danieltyukov/owltunes/docs/hardware/README.md

# Hardware documentation

| Document | What it covers |
|---|---|
| [rev-a.md](rev-a.md) | Rev A blocks, mechanical stack, calculations, power budget, decisions |
| [pinmap.md](pinmap.md) | ESP32-S3 pin map (source: `firmware/main/board_owltunes_reva.h`) |
| [ring-test.md](ring-test.md) | Ring test prints, measurements and the decision record |
| [assembly.md](assembly.md) | Building an owl from the ordered parts |
| [bringup.md](bringup.md) | First power-on and checks |
| [ordering.md](ordering.md) | JLCPCB and JLC3DP settings, parts not on the boards |
| [rev-a-review.md](rev-a-review.md) | Design review before ordering |

KiCad projects: `hardware/`. Enclosure sources: `enclosure/`. Licence: CERN-OHL-P-2.0.
