danieltyukov/owltunes/sim/golden/ad_break.png

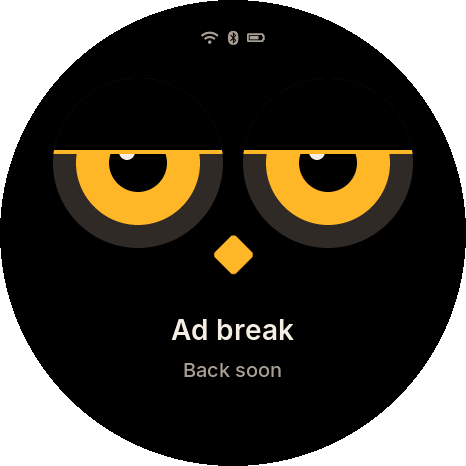
sim/golden/ad_break.png
