danieltyukov/owltunes/sim/golden/devices.png

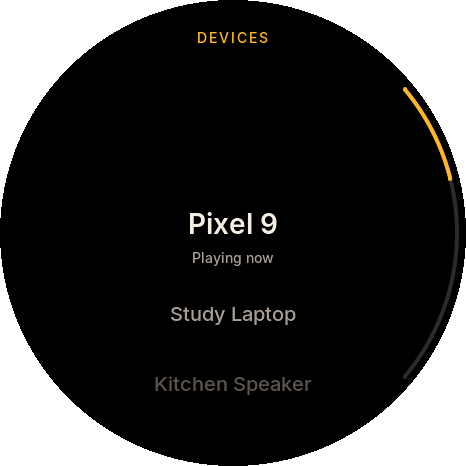
sim/golden/devices.png
