danieltyukov/owltunes/sim/golden/loading.png

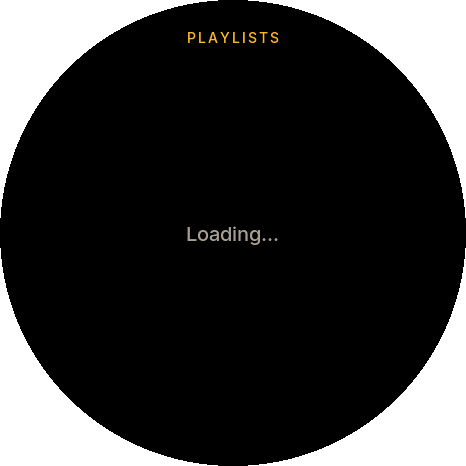
sim/golden/loading.png
