danieltyukov/owltunes/sim/golden/now_playing_unicode.png

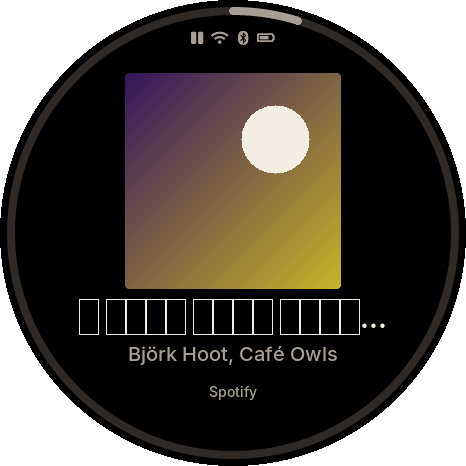
sim/golden/now_playing_unicode.png
