danieltyukov/owltunes/sim/golden/offline.png

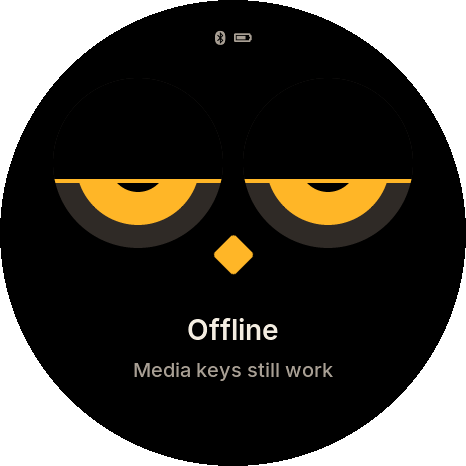
sim/golden/offline.png
