danieltyukov/owltunes/sim/golden/presets_screen.png

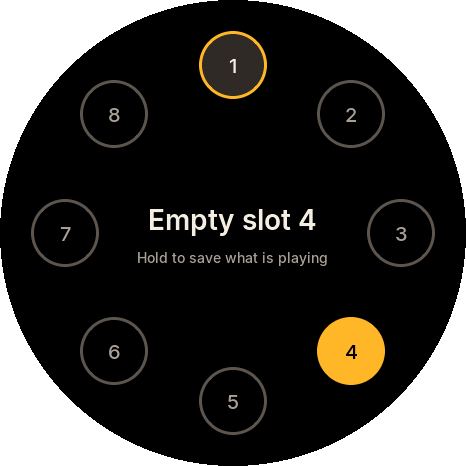
sim/golden/presets_screen.png
