danieltyukov/owltunes/docs/hardware/assembly.md

# Assembling an owl (rev A)

Tools: a soldering iron (for the inserts at 220 C, with a heat-set insert tip or a clean conical
tip, and for the LRA leads), solder and 1.5 mm heat-shrink tubing, a multimeter, a 1.3 mm hex key
for the ISO 7380 M2 button heads, cyanoacrylate glue, black 0.2 mm double-sided tape (the glass,
step 9), 1 mm double-sided foam tape (battery end stop, step 8), two-part epoxy (the bearing on its
seat, step 3) and a flat plate (glass or a steel rule) covered with release film (PTFE film or
packing tape) to set the bearing on. No crimp tool: the LRA gets a pre-crimped pigtail. Keep
cyanoacrylate away from the cover glass: its vapour leaves a white film. Also a piece of soft
silicone thermal gap pad, about 5 x 5 mm and 1.5 mm thick, 1 to 3 W/mK, electrically insulating
(see step 8).

The ring variant (A with the 6710 bearing, B with the printed bushing) and the magnet count come
from the ring test; see [ring-test.md](ring-test.md).

1. **Inserts.** Press M2 x 3 mm heat-set inserts into the four body bosses (behind the head
   corners and the belly) and the four back-cover standoffs.
2. **Magnets.** Ring carrier: alternate the polarity (see `ring-test.md`), a drop of glue each.
   The product carrier has no polarity bumps, so check each magnet against its neighbour with a
   reference magnet before the glue sets. Back cover: two D6 x 2 mm magnets in the cups at
   (+-20, -22), north facing out; the perch magnets face south out so they attract.
3. **Ring.** Cover the flat plate with release film and lay the bezel face down on it. Spread
   two-part epoxy thinly on the bearing seat, keeping it off the shields, and slide the bearing (or
   the bushing sleeve) onto the bezel tube from the back until it touches the plate: its front face
   is then flush with the bezel's front face, which is the glass ledge. The bearing pushes some
   epoxy forward: before it sets, lift the bezel off the film and wipe the bezel's front face and
   the inner race's front face clean, because they carry the glass tape, then lay it back face down.
   There is no lip in front of the bearing, so the epoxy holds it in both directions; let it set
   before going on. Press the ring on from the front until its lip rests on the outer race, and
   push the carrier into the ring from the back until its flange meets the ring.
4. **Keys.** Beak key into the face slot from inside; ear keys into the top slots from inside.
5. **LRA.** The motor's two leads (red and blue, about 27 mm, AWG 32) are spliced to a pre-crimped
   JST SH 1.0 mm 2-pin pigtail whose housing plugs into J302. Trim the pigtail to about 20 mm from
   its housing, slide a 10 mm piece of 1.5 mm heat-shrink tubing over each of its wires, strip
   about 3 mm of each wire and each motor lead, twist and solder red to the wire in housing pin 1
   and blue to pin 2, then shrink the tubing over the joints. The LRA has no polarity; the order
   only keeps every owl the same. Glue the motor into the back cover cup with its lead tab in the
   slot of the cup wall; the splices lie between the cup and J302.
6. **Battery.** The pack is a 2-wire 1S LiPo of the 803030 class (8 x 30 x 30 mm) with a protection
   circuit and a JST PH 2.0 2-pin plug: efaso 803030 740 mAh, or EEMB 803030 700 mAh if its plug is
   confirmed as PH 2.0 (2.0 mm pitch, not PH 1.25 or SH 1.0). The cavity is drawn for an 803040
   (8 x 30 x 40 mm), so the shorter cell is held by a foam end stop (step 8). The pack needs no NTC
   wire: the charger reads RT101, an NTC on the board under the cell. A 3-wire pack (with its own
   NTC) works too: move its positive and negative contacts into a 2-pin JST PHR-2 housing and
   insulate the NTC wire, which is unused. J101 has no reverse-polarity protection, and many packs
   are wired the other way round. Before plugging in, hold the plug the way it mates with J101 and
   check with a multimeter that the contact facing the `+` mark (pin 1, with the dot) is positive
   and the one facing `-` is negative; the red wire should be on `+`. If the order differs, lift
   each contact's latch with a needle and swap the two wires. No soldering. Do this for every pack,
   the spare too: J101 pin 1 is VBAT and pin 2 is GND.
7. **Dock pads.** Snap the dock-pad section off the perch board at the mouse bites, with pliers on
   the tab at the bite row, and file the nub flat: the owl recess and the perch pocket have a 0.8
   mm relief at the neck, but a nub over 0.4 mm reaches the battery margin. The section goes in one
   way only: J2 towards J303. Lay the back cover inner face up with its top edge away from you and
   glue the section into the recess with the gold pads facing out (down), J2 at the right (the LRA
   cup's end, the owl's right) and the notch at its other end over the tongue at the recess's left
   end. The silkscreen reads `J2 towards J303 >`, and the VBUS pad is the one nearest J2. If the
   section does not lie flat in the recess it is the wrong way round: turned, the VBUS pad would
   meet the perch's DET pin and put 5 V on GPIO1. Plug a straight 4-pin JST SH cable (pin 1 to pin
   1) into its J2; the other end goes to J303 on the main board in step 8. Before the first dock,
   with the cable in J2 and J303 and the cover not yet closed, check with a meter through the
   cover's pad windows: J303 pin 2 to the pad nearest J2 and J303 pin 3 to the pad farthest from J2
   show continuity (near 0 ohm). J303 pin 1 is at the end with the short silkscreen tick, on the
   left seen from the back (the owl's right). Any other result means a turned section or a reversed
   cable: fix it before the owl goes on a perch.
8. **Stack.** Put the main board into the body from the back, then the bezel and ring into the face
   opening so the bezel lugs rest on the board. Press the thermal gap pad onto the back of the
   board, centred on RT101's copper patch (the 4.5 x 3 mm rectangle under the mask, 4.5 mm below
   the centre of U303, with RT101 just past its right-hand end seen from the back; see
   [rev-a.md](rev-a.md), Off-board parts), so the cell rests on it. The battery space runs between
   the four cover standoffs, from the top edge of the dock-pad recess in the cover up to just below
   J101's plug. Lay the cell in lead end up, with its leads leaving the half of its top edge on the
   owl's right (your left, seen from the back) for J101, and check that it covers the gap pad. It
   is about 8 to 10 mm shorter than the space: stick an end stop of 1 mm double-sided foam tape to
   the inside of the back cover, just above the dock-pad recess, about 25 mm wide and three to five
   layers high, cut deep enough that it holds the cell's top edge just below J101's plug. Keep tape
   and foam off the cell's two large faces: the battery layer is 9.2 mm deep and the board's
   back-side parts under the cell stand up to 1.1 mm, so an 8 mm cell has only 0.1 to 0.2 mm to
   spare. The gap pad presses the cell against the cover once it is closed. Fold the spare battery
   lead into the space on the owl's right of the cell (your left, seen from the back), between the
   two cover standoffs on that side and clear of the LRA cup. Put the battery, motor plug and dock
   cable in place (J101, J302, J303), do the meter check of step 7 and close the back cover. Screw
   four ISO 7380 M2 x 6 from the front through the bezel lugs and the board into the cover
   standoffs, and four ISO 7380 M2 x 14 from the back through the cover spacers and the board into
   the body bosses. The back screw heads sit just below the cover's back face.
9. **Display.** The cover glass is laminated to the panel. The bearing must have passed the check
   in ring-test.md (M5): its inner race land reaches past the 52.75 mm largest glass edge and no
   shield stands proud of the race face; if one does, use tape thicker than 0.2 mm by that much.
   First lay a ring of the black 0.2 mm tape on the bezel's front face and on the inner race's front face (or the bushing sleeve's) out
   to 52.0 mm, at least 0.8 mm from the gap at the shields and open over the flex notch at 12
   o'clock. Lay the panel face down on a cloth and plug the adapter FPC into the panel connector
   (contacts towards the panel, the positioning line at the connector face). Then put the
   adapter's free end into J301 through the bezel opening (contacts down, the connector is bottom
   contact; pin 1 marking at J301's `31` end, which is the south end; connector pin k = panel pin
   32 - k) and close the latch. Lower the display into the bezel from the front so the adapter
   forms its U-turn towards 9 o'clock over the H2 lug: the panel goes into its pocket and the glass
   border comes down on the tape. Press the glass down evenly all round. Nothing but the tape holds
   the glass: there is no retainer, and only the turning ring surrounds its edge, about 0.5 mm
   away.
