danieltyukov/owltunes/sim/golden/setup_linking.png

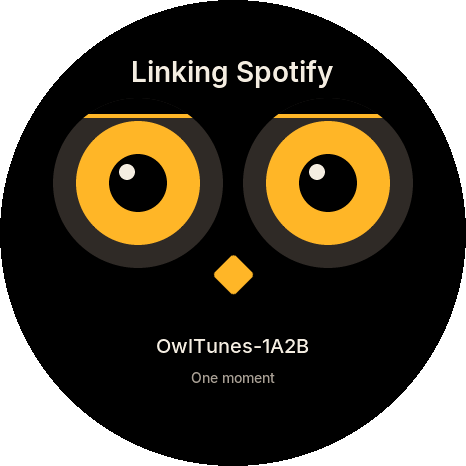
sim/golden/setup_linking.png
