danieltyukov/owltunes/hardware/perch-dock/perch-dock.kicad_pcb

## KiCad design hardware/perch-dock/perch-dock.kicad_pcb (2026-10-12)

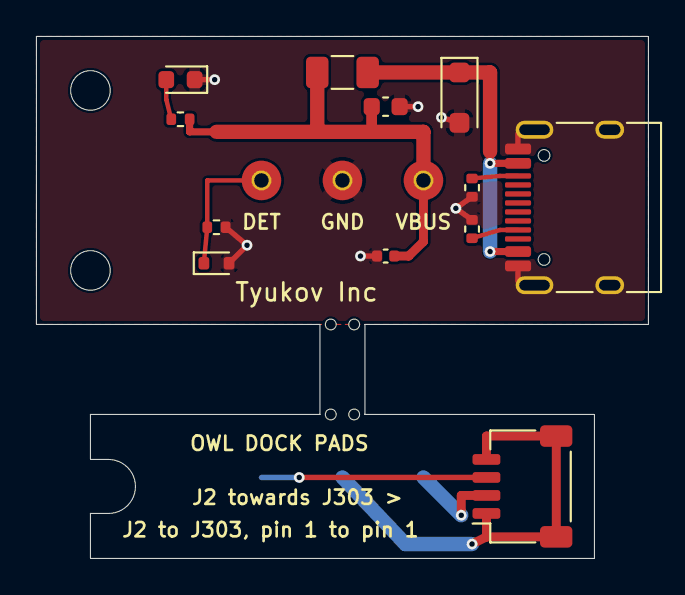
[picture p18: board perch-dock.kicad_pcb from above]

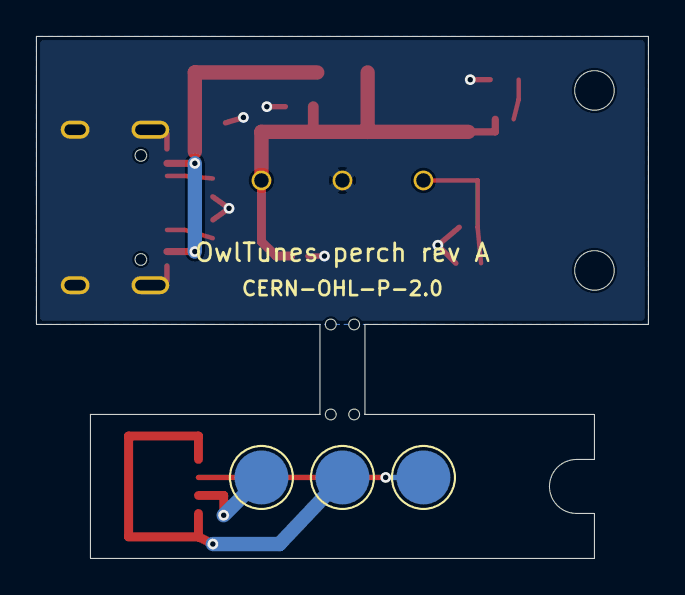
[picture p19: board perch-dock.kicad_pcb from below]

Board: 2 copper layers, 34.0 x 29.0 mm, 22 parts (3 on the bottom side), 10 nets.

Parts:
C1: 10uF; C_0603_1608Metric
C2: 100nF; C_0402_1005Metric
D1: SMF5.0A; D_SOD-123F
D2: LESD5D5.0CT1G; D_SOD-523
F1: 1.1A hold; Fuse_1206_3216Metric
H1, H2: M2; MountingHole_2.2mm_M2
J1: USB-C power; USB_C_Receptacle_HRO_TYPE-C-31-M-12
J2: To J303: GND, VBUS, DET, GND; JST_SH_SM04B-SRSS-TB_1x04-1MP_P1.00mm_Horizontal
LED1: red; LED_0603_1608Metric
MB1, MB2: Breakaway; MouseBite_2.5mm_2x0.6mm
P1: Pogo DET; PogoPin_Xinyangze_YZ71215080P-02
P2: Pogo GND; PogoPin_Xinyangze_YZ71215080P-02
P3: Pogo VBUS; PogoPin_Xinyangze_YZ71215080P-02
PAD1: DET; TestPoint_Pad_D3.0mm
PAD2: GND; TestPoint_Pad_D3.0mm
PAD3: VBUS; TestPoint_Pad_D3.0mm
R1, R2: 5.1k; R_0402_1005Metric
R3: 10k; R_0402_1005Metric
R4: 4.7k; R_0402_1005Metric

Connections:
DOCK_ID: D2.1, P1.1, R3.1
GND: C1.2, C2.2, D1.2, D2.2, J1.A1, J1.A12, J1.B1, J1.B12, J1.SH, LED1.1, P2.1, R1.2, R2.2, R3.2
LED_A: LED1.2, R4.2
PAD_DET: J2.3, PAD1.1
PAD_GND: J2.1, J2.4, J2.MP, PAD2.1
PAD_VBUS: J2.2, PAD3.1
PERCH_CC1: J1.A5, R1.1
PERCH_CC2: J1.B5, R2.1
VBUS_IN: D1.1, F1.1, J1.A4, J1.A9, J1.B4, J1.B9
VBUS_OUT: C1.1, C2.1, F1.2, P3.1, R4.1
