danieltyukov/owltunes/sim/src/sim_scenarios.c

#include "sim_scenarios.h"

#include <stdio.h>
#include <stdlib.h>
#include <string.h>

#include "sim_art.h"
#include "spotify_parse.h"

static char *read_fixture_file(const char *name, size_t *len)
{
    char path[512];
    snprintf(path, sizeof path, "%s/%s", OWL_FIXTURE_DIR, name);
    FILE *f = fopen(path, "rb");
    if (f == NULL) {
        fprintf(stderr, "missing fixture %s\n", path);
        exit(2);
    }
    fseek(f, 0, SEEK_END);
    long size = ftell(f);
    fseek(f, 0, SEEK_SET);
    char *buf = malloc((size_t)size + 1);
    *len = fread(buf, 1, (size_t)size, f);
    buf[*len] = '\0';
    fclose(f);
    return buf;
}

void sim_load_player(sim_world_t *w, const char *fixture)
{
    size_t len;
    char *json = read_fixture_file(fixture, &len);
    if (spotify_parse_player(json, len, w->now_ms, &w->player) != SPOTIFY_PARSE_OK) {
        fprintf(stderr, "cannot parse %s\n", fixture);
        exit(2);
    }
    free(json);
}

void sim_load_list(sim_world_t *w, owl_list_kind_t kind, const char *fixture, const char *source_uri)
{
    size_t len;
    char *json = read_fixture_file(fixture, &len);
    if (spotify_parse_list(kind, json, len, SIM_USER_ID, source_uri, &w->list) != SPOTIFY_PARSE_OK) {
        fprintf(stderr, "cannot parse %s\n", fixture);
        exit(2);
    }
    free(json);
}

void sim_input(sim_world_t *w, owl_input_kind_t kind, int32_t steps)
{
    owl_effects_t fx;
    owl_input_t in = {kind, steps};
    owl_app_handle(&w->app, &w->player, &in, w->now_ms, &fx);
}

static void base(sim_world_t *w)
{
    memset(w, 0, sizeof *w);
    owl_app_init(&w->app);
    owl_app_set_link(&w->app, OWL_LINK_API, true);
    owl_player_init(&w->player);
    w->inputs.battery_percent = 82;
    w->inputs.wifi = true;
    w->inputs.ble = true;
    w->now_ms = 100000;
}

static void no_device(sim_world_t *w)
{
    base(w);
    spotify_parse_player(NULL, 0, w->now_ms, &w->player);
}

static void now_playing(sim_world_t *w)
{
    base(w);
    sim_load_player(w, "player_track.json");
    w->player.liked = true;
    w->inputs.art = sim_art_for(w->player.track.uri);
}

static void now_playing_unicode(sim_world_t *w)
{
    base(w);
    sim_load_player(w, "player_unicode_paused.json");
    w->inputs.art = sim_art_for(w->player.track.uri);
}

static void now_playing_volume(sim_world_t *w)
{
    now_playing(w);
    w->player.device.volume_percent = 64;
    w->app.volume_overlay_until_ms = w->now_ms + 500;
}

static void offline(sim_world_t *w)
{
    base(w);
    owl_app_set_link(&w->app, OWL_LINK_NONE, true);
    w->inputs.wifi = false;
}

static void ad_break(sim_world_t *w)
{
    base(w);
    sim_load_player(w, "player_ad.json");
}

static void library(sim_world_t *w)
{
    now_playing(w);
    sim_input(w, OWL_IN_SWIPE_UP, 0);
}

static void playlists(sim_world_t *w)
{
    library(w);
    sim_input(w, OWL_IN_TAP, 0); /* cursor 0 = Playlists */
    sim_load_list(w, OWL_LIST_PLAYLISTS, "playlists.json", NULL);
    owl_app_set_list(&w->app, &w->list);
    sim_input(w, OWL_IN_RING, 1);
}

static void devices(sim_world_t *w)
{
    library(w);
    sim_input(w, OWL_IN_RING, OWL_LIB_DEVICES);
    sim_input(w, OWL_IN_TAP, 0);
    sim_load_list(w, OWL_LIST_DEVICES, "devices.json", NULL);
    owl_app_set_list(&w->app, &w->list);
}

static void loading(sim_world_t *w)
{
    library(w);
    sim_input(w, OWL_IN_TAP, 0); /* the playlists request has not answered yet */
}

static void playlist_items(sim_world_t *w)
{
    playlists(w); /* cursor 1 = Barn Party, a collaborative playlist that opens */
    sim_input(w, OWL_IN_TAP, 0);
    sim_load_list(w, OWL_LIST_PLAYLIST_ITEMS, "playlist_items.json",
                  "spotify:playlist:1wPw7n0lU8cLKk8qJx6lRZ");
    owl_app_set_list(&w->app, &w->list);
}

static void assign(sim_world_t *w, int slot, const char *uri, const char *label)
{
    w->app.presets[slot].assigned = true;
    snprintf(w->app.presets[slot].uri, sizeof w->app.presets[slot].uri, "%s", uri);
    snprintf(w->app.presets[slot].label, sizeof w->app.presets[slot].label, "%s", label);
}

static void presets_wheel(sim_world_t *w)
{
    now_playing(w);
    assign(w, 0, "spotify:playlist:3cEYpjA9oz9GiPac4AsH4n", "Night Flight Mix");
    assign(w, 1, "spotify:playlist:37i9dQZF1DXbITWG1ZJKYt", "Owl Jazz");
    assign(w, 4, "spotify:album:2up3OPMp9Tb4dAKM2erWXQ", "Moonlit Barn");
    sim_input(w, OWL_IN_EAR_LEFT_HOLD, 0);
    sim_input(w, OWL_IN_RING, 1);
}

static void presets_screen(sim_world_t *w)
{
    library(w);
    assign(w, 0, "spotify:playlist:3cEYpjA9oz9GiPac4AsH4n", "Night Flight Mix");
    sim_input(w, OWL_IN_RING, OWL_LIB_PRESETS);
    sim_input(w, OWL_IN_TAP, 0);
    sim_input(w, OWL_IN_RING, 3); /* an empty slot */
}

#define SIM_OWL_NAME "OwlTunes-1A2B"
#define SIM_SETUP_URL "https://danieltyukov.github.io/owltunes/setup/?owl=" SIM_OWL_NAME

static void setup_screen(sim_world_t *w, owl_ui_setup_mode_t mode, const char *error)
{
    base(w);
    w->inputs.ble = false;
    w->inputs.setup = (owl_ui_setup_t){mode, SIM_SETUP_URL, SIM_OWL_NAME, error};
}

static void setup_welcome(sim_world_t *w)
{
    setup_screen(w, OWL_UI_SETUP_WELCOME, NULL);
    w->inputs.wifi = false;
}

static void setup_link(sim_world_t *w)
{
    setup_screen(w, OWL_UI_SETUP_LINK, NULL);
}

static void setup_linking(sim_world_t *w)
{
    setup_screen(w, OWL_UI_SETUP_LINKING, NULL);
}

static void setup_link_failed(sim_world_t *w)
{
    setup_screen(w, OWL_UI_SETUP_LINK, "Spotify rejected the client ID");
}

static void setup_relink(sim_world_t *w)
{
    setup_screen(w, OWL_UI_SETUP_RELINK, NULL);
}

static const sim_scenario_t SCENARIOS[] = {
    {"no_device", no_device},
    {"now_playing", now_playing},
    {"now_playing_unicode", now_playing_unicode},
    {"now_playing_volume", now_playing_volume},
    {"offline", offline},
    {"ad_break", ad_break},
    {"library", library},
    {"playlists", playlists},
    {"devices", devices},
    {"loading", loading},
    {"presets_wheel", presets_wheel},
    {"presets_screen", presets_screen},
    {"playlist_items", playlist_items},
    {"setup_welcome", setup_welcome},
    {"setup_link", setup_link},
    {"setup_linking", setup_linking},
    {"setup_link_failed", setup_link_failed},
    {"setup_relink", setup_relink},
};

size_t sim_scenario_count(void)
{
    return sizeof SCENARIOS / sizeof SCENARIOS[0];
}

const sim_scenario_t *sim_scenario_at(size_t index)
{
    return index < sim_scenario_count() ? &SCENARIOS[index] : NULL;
}

const sim_scenario_t *sim_scenario_find(const char *name)
{
    for (size_t i = 0; i < sim_scenario_count(); i++) {
        if (strcmp(SCENARIOS[i].name, name) == 0) {
            return &SCENARIOS[i];
        }
    }
    return NULL;
}
