danieltyukov/owltunes/(commit log)

2026-10-04 docs: add OwlTunes system design spec
    Covers the owl handheld and desk perch, electronics, firmware architecture,
    Spotify Web API constraints, setup flow, UX, testing and delivery phases.
2026-10-04 feat(core): add button gesture recognition and ring step decoding
2026-10-04 feat(spotify): parse playlists, library, queue, devices and item lists
2026-10-04 feat(ui): add the centre-weighted list page for library, playlists and devices
2026-10-04 feat(ui): add the preset wheel and presets screen
2026-10-04 feat(firmware): add the ESP32-S3 firmware skeleton that boots the owl UI in QEMU
    Verified locally: the build has no warnings, and in QEMU the embedded player
    JSON parses and the UI loop logs OWL_BOOT_OK; a screenshot of the virtual panel
    shows the Now Playing page.
2026-10-04 fix(core): keep playlist and album names, and refuse to like local files
    Opening a playlist or album now records its name in the navigation frame, so
    playing from one of its tracks keeps the context name for presets and the list
    heading shows the name. Local files are no longer treated as likeable tracks.
    The spec now states the 216 px art size the UI uses.
    [sim_scenarios.c]
2026-10-10 docs: fix the pasted-line link flow and the monitor advice, and add setup caveats
2026-10-10 feat(enclosure): add ring test prints, sensor jig and field log analysis
2026-10-10 fix(enclosure): make the bezel glass fit in, fit the carrier to both rings, and use real SparkFun board data
    The glass now drops in from the front through a 48.5 mm opening. The carrier body is
    derived from the smaller ring bore with a named clearance. The jig places the TMAG5273 chip
    (from SparkFun's board file) on the sensor position, with a cable slot at connector J2, and
    its geometry is probed in tests. Nut pockets get clearance, the O-ring is 59 x 1.5 with a
    computed squeeze and stretch, and the magnet face depth matches a seated magnet. The log
    analysis uses percentiles, rejects glitches and non-finite samples, removes DC bias and
    tells a wrong turn length from a wrong polarity order.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
2026-10-10 fix(enclosure): bring every wall up to JLC3DP's MJF minimums
    Adds MJF_MIN_WALL (0.8, non-critical) and MJF_STRUCT_WALL (1.0, structural). Ring lip, FPC
    notch, carrier ID, front depth, flange and pocket depth change so every structural wall is at
    least 1.0 mm and the glass pocket wall is 0.8 mm. The wall test now measures chords along probe
    lines through each solid. Documents that the product carrier uses bumps=False.
2026-10-10 feat(hardware): add KiCad projects, JLC rules and the connectivity and ERC/DRC checks
2026-10-11 feat(firmware): pick the board with Kconfig, move QEMU into a board component and add the OTA flash layout
2026-10-11 feat(hardware): add the custom part library with datasheet pin checks
    hw_lib_build.py writes the five symbols from the datasheet pin tables and the
    footprints from the manufacturers' land patterns (TI DLA0010A and DNP0006A,
    Maxim 90-0065, Hirose FH26W, Murata DFE201612E, the pogo pin drawing), in
    the EasyEDA/JLC zero orientation, through kicad-cli so the files are what
    KiCad saves. EasyEDA data from JLC2KiCadLib is compared as a second source
    and supplies the untracked 3D models. The ESP32-S3-WROOM-1 copy opens the
    thermal vias to 0.3 mm.
    test_hw_library.py checks pin names and types, every pad, the printed
    drawing dimensions, stencil openings, courtyards, drills, the stock
    footprints the b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
2026-10-11 feat(firmware): add the Arduino Nano ESP32 board with octal PSRAM, a headless UI and the USB console
2026-10-11 docs: say which Nano ESP32 features arrive in later tasks and document console drops and a busy port
2026-10-11 feat(firmware): show the owl's status on the Nano ESP32's RGB LED
2026-10-11 fix(firmware): switch the status LED off before a restart, take one status snapshot per frame and count statuses
2026-10-11 fix(hardware): follow Hirose's stencil on J301 and keep pogo pin paste off its hole
    The FH26W contacts and tabs no longer print paste in full: paste-only
    openings follow the recommended stencil on EDC3-323714-05 p. 1 (0.23 wide,
    0.55 and 0.65 long flush with the pads' outer ends, tab openings 0.3 x 0.7).
    The pogo pin prints a ring of paste from 0.55 mm to the pad edge instead of
    a disc over its plated hole.
    The library test now compares every paste opening with the datasheet
    stencils, measures Hirose's printed stencil dimensions and checks the pogo
    ring against the hole; pins and lands count copper pads only. kicad-cli
    failures in the build script and the rebuild test print KiCad's output.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
2026-10-11 test(tools): flash, reset and check the Nano ESP32 from the host
2026-10-11 feat(enclosure): add enclosure v1 and the main board mechanical contract
    pcb_contract.py writes hardware/owl-mainboard/mech/contract.json: board
    outline, the 12 fixed parts with body boxes in the footprint frame, the
    EVQ-P7A knob box from the Panasonic drawing, mounting holes and keep-outs
    around every boss, the bezel lugs and the ring. U201 is placed at rot 180
    so the antenna points into the notch (checked with pcbnew); JST SH heights
    are 2.95.
    owl_v1.py builds the body, back cover, product bezel, a glass retainer
    ring, the beak and ear keys, the rings and the bump-free carriers. Every
    printed wall is at least 0.8 mm (1.0 where structural). The product Hall
    gap stays at 3.0 mm, provisional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
2026-10-11 feat(hardware): draw the main board power sheet (charger, gauge, 3.3 V, display switch)
2026-10-11 fix(enclosure): recess the back screw heads and record the glass retention
    The back cover counterbores were 1.0 mm deep, so the bought ISO 7380 M2
    button heads (k 1.3) stood 0.3 mm proud of the 23.5 mm envelope. They now
    run through the 1.5 mm plate (heads 0.2 mm below the back face), with a
    collar inside the plate around each boss to keep a 1.0 mm wall at the
    counterbore edge. owl_params names the screws (M2 x 6 front, M2 x 14
    back) and their head size; tests place a head and shank in every hole.
    The README lists the adhesive glass retention as an owner review point,
    with a mechanical lock for v2.
2026-10-11 feat(firmware): join the saved Wi-Fi networks in order with backoff and report failures to the setup page
    The Nano ESP32 gets Wi-Fi station mode (net_wifi.c, selected by CONFIG_OWL_NET_WIFI): one task
    carries out the owl_wifi plan, reports every failed attempt as a network failed event naming the
    SSID and the reason, and starts the radio even with nothing saved. Provisioning keeps only the
    newest network state and hands the saved networks over at boot. net_none.c is gone.
    On the board ESP-IDF v6.1 reports the owl's own leave during a scan or after a failed attempt as
    STA_LEAVING (36), which made the next saved network fail at once; the plan now ignores that reason
    unless the owl is online.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
2026-10-11 fix(hardware): limit the charger input to USB 2.0 default power and keep the USB attach capacitance under 10 uF
2026-10-11 fix(provisioning,tools): refuse an escaped NUL in wifi_add and tighten the Nano Wi-Fi checks
    wifi_add now refuses a request whose raw line holds the escape for U+0000, which cJSON
    decodes to a zero byte that cut the SSID or password short. In hil_nano.py the LAN check
    uses the page's ranges, the "up" marker is taken after the removals, the dummy password
    differs from the dummy SSID and the console log is checked for it, and the RAM floor is
    checked again after the join. wifi_checks gets a host test with a fake board.
2026-10-11 feat(hardware): draw the main board MCU, USB-C and button sheet
    The mcu_usb sheet carries the ESP32-S3-WROOM-1-N16R8 with 22 uF + 100 nF at
    its 3V3 pin, the EN network (10k, 1 uF, reset pad), the GPIO0 pull-up with
    the boot pads, the 32.768 kHz crystal with 18 pF load capacitors, USB-C with
    a separate 5.1k Rd per CC pin, USBLC6-2SC6, 22 ohm series resistors and the
    VBUS TVS, the three buttons with 100k pull-ups and 10 nF, the J202 expansion
    connector with 10k pull-ups, the UART pads, a notes box and the GPIO table.
    TPS63802 PG now reaches ESP_EN through R212 (1k) on its own net TPS_PG, so
    the open-drain PG output no longer discharges the 1 uF EN capacitor directly.
2026-10-11 feat(provisioning): refuse spotify_begin while the owl is offline
    esp_fill_random is truly random only while the radio runs. The real boards start Wi-Fi before the
    console, and the owl now also refuses to start a login until it is online, so the PKCE verifier
    is always made with the radio on, whatever the start-up order (bootloader_random_enable() must
    not run beside the radio). Offline, the login could not finish anyway and the state would carry
    no address for the LAN fallback. The reply is the new error offline; a login that is already
    open stays open. The setup page explains it, the fake owl in the page tests refuses the same
    way, and tools/hil_nano.py checks the refusal on a board with n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
2026-10-11 test(tools): link a board to Spotify through a loopback redirect and check the boot refresh
    tools/owl_login.py serves http://127.0.0.1:8765/callback, saves the client ID on the owl with
    that redirect URI, prints the login address and hands Spotify's code to the owl over USB; the owl
    exchanges it itself. It then resets the owl and waits for the saved login to pass its boot check.
    Opening the port restarts the Nano, so the script opens it once, waits for the owl to start and
    come online, and keeps it open. It listens before it saves the redirect URI, skips callbacks
    for another login, shows the client ID as <redacted> in the console log (Board.redact) and
    fails if the log holds a token name or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
2026-10-11 fix(hardware): keep TPS63802 PG under 1 mA on the ESP32 EN network and leave the USBLC6 VBUS pin open
    EN now uses R205 47k, C203 220 nF and R212 4.7k: PG sinks at most
    3.3 V / 4.7k = 0.70 mA, the divider holds EN at 0.30 V or less while PG is
    low, EN releases with a 10.3 ms time constant and PG glitches shorter than
    about 1 ms are filtered.
    U202 pin 5 is no longer tied to VBUS_USB, so the ESP32-S3's D+ pull-up
    cannot back-feed the receptacle VBUS through the upper steering diode while
    unplugged.
    The notes boxes on both sheets state these numbers, and the mcu_usb notes
    record that the U0TXD 499 ohm series resistor is inside the module.
2026-10-11 feat(spotify): ask whether the current track is in the person's library
2026-10-11 fix(tools,firmware): redact client IDs in every console log and throttle the callback stop log
    Board's log writer now shows every 32-hex client ID as <redacted> by pattern (the "client_id"
    field of hello and client_id= in an authorize URL), whatever the script and whether or not the
    ID was passed in; tools/qemu_prov_test.py uses the same redact_line. The loopback callback
    server in tools/owl_login.py runs each connection on its own thread with a 10 s timeout, so a
    stray connection cannot hold up Spotify's redirect. A failing httpd_stop is still retried on
    every pass but logged at once, then at most every 30 s with the attempt count, and once when it
    finally stops. The PKCE comments and the p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
2026-10-11 feat(hardware): draw the display, sensor and dock sheet; main board ERC clean
    The periph sheet carries J301 (FH26W-31S, connector pin k = panel pin
    32 - k as on the Waveshare 1.75 kit J3) with a pin table aligned to the
    connector pins, the panel decoupling and the touch bus pull-ups to
    DISP_3V3, the DRV2605L on +3V3 with the LRA connector, the TMAG5273A2,
    the LIS2DW12, the OPT3001, the sensor bus pull-ups, and the dock link
    (J303, SMF5.0A, DOCK_DET divider with ESD). hw_netlist now runs in CI
    for the main board.
    One change to the planned parts: LIS2DW12 SDO/SA0 reaches +3V3 through
    R309 10k (C25744, already on the board) on the new net IMU_SA0 instead
    of a hard tie. The pin is an I/O (SPI S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
2026-10-11 feat(firmware): add the rev A pin map header with a host test of the ESP32-S3 pin rules
2026-10-11 feat(tools): check the rev A pin map header against the main board netlist
2026-10-11 feat(hardware): bring the main board schematic into the PCB and apply the enclosure contract
    hw_sync.py is the scripted Update PCB from Schematic (footprints, fields, symbol paths,
    attributes, pad nets; placed parts keep their position). hw_contract.py applies the outline,
    fixed parts and holes from contract.json and checks them, the battery-zone heights, the
    Hall-sensor keep-out, the boss, lug and ring keep-outs and each fixed part's body against the
    box the enclosure reserves for it.
2026-10-11 docs(hardware): add the rev A notes, pin map, assembly and bring-up guides
2026-10-11 docs(hardware): state the worst-case charger input limit and where to read the TS voltage
2026-10-11 fix(firmware): give the typical and worst-case charger input limit in the rev A header
2026-10-11 fix(enclosure): turn J301 to 180 degrees so the display flex enters from the panel's top edge
    The FH26W takes the FPC from footprint +v. At rot 0 that side faced the display centre, so the
    flex that folds over the panel's top edge and runs down behind it would have needed a second
    fold. At rot 180 it runs straight in; the reach stays provisional until the paper check.
2026-10-11 feat(hardware): place the main board against the enclosure contract
    hw_place.py places the 86 free parts by function (decoupling at the pins they serve, charger in
    the right strip outside the battery, 3.3 V block at the cell edge with L101 clear of the cell,
    U104 outside the H2 boss ring, ESD and TVS at the connectors) and puts each reference where it
    clears all copper. J101 carries + NTC - and a pin 1 dot. fit_check.py checks the STEP export,
    plus the contract boxes for parts without a local 3D model, against enclosure v1. The contract
    check runs in CI. The stackup test compares tokens, since pcbnew re-indents the block.
2026-10-11 fix(shell): accept transfer ids of 1 to 63 characters, the length a command can hold
    owl_cmd_t keeps a device id in 64 bytes, so a 64-character id parsed but
    was refused later as no_such_device. The console now answers it with
    bad_arg at once (P16 as amended), and a 63-character id reaches the command
    whole.
2026-10-11 feat(hardware): keep parts out of the strips beside the antenna notch in the contract
    The contract now lists 3 mm strips either side of both notch edges above y 33, on both board
    sides, as keep-outs that name U201. hw_contract.py exempts the part a keep-out names, so the
    module itself does not trip its own strips; every other courtyard must stay out.
2026-10-11 feat(firmware): poll Spotify and send console commands through the runtime
    The runtime now talks to the Web API over the kept-alive connection. Each
    pass sends at most one request: the oldest queued command, then a device
    list or like check the console asked for, then the playback poll when the
    spec 9.4 scheduler says it is due. Every answer goes to the shared gate
    (api_gate_record_web); a 401 gets one forced token refresh and one more
    try, and a request that could not get a token records nothing. Commands
    are resolved against the last known state, applied optimistically and
    confirmed by the poll half a second later. While the gate is closed,
    playback commands and devices are refused with ba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
2026-10-11 docs: describe the console's playback commands, player, device and api lines
    docs/console.md now covers the commands the runtime sends to Spotify,
    the cmd states and every error code (backoff distinct from rate_limited,
    P18), the player and device lines and the screen-on polling window. The
    board guide says which statuses show once the owl reads the playback
    state.
2026-10-11 fix(hardware): raise R102 to 3.6k so the charger input limit stays under 500 mA at its worst case
2026-10-11 docs(hardware): an open TS reads as cold on this board, so the pack needs its 10k NTC
2026-10-11 docs(hardware): give the R102 3.6k input limits and rework the bring-up battery step
2026-10-11 docs(firmware): note that ext1 must only arm the rev A wake pins that read high
2026-10-11 fix(tools): fail the pin map check when the header has no pins or the netlist has no U201 GPIOs
2026-10-11 test(firmware): run the Spotify runtime's steps on the host
    test_spotify_task builds spotify_task.c and the shared gate against
    stand-ins for FreeRTOS, the token service and the transport. It pins the
    request order (one per pass, commands first, the confirming poll 500 ms
    later), the 401 path (one forced refresh, one more try, then auth), that a
    request without a token is neither sent nor recorded, refusals while the
    gate is closed with backoff distinct from rate_limited (P18), the quota
    lockout's BLE link, device numbers for transfer and what stopping does.
2026-10-11 fix(hardware): cut the WROOM-1 antenna keep-out to the owl notch and strips
    Ruling R43: the module copy's courtyard and rule area (no tracks, vias, pads, pour or parts on
    any copper layer) now cover only the board notch plus the 3 mm strips beside it, the same
    geometry as the contract keep-outs, instead of Espressif's 48 x 21 mm area that held the ear
    switches. Espressif's 15 mm keep-out cannot fit in the 66 x 84 mm owl; RSSI is measured at
    bring-up and the ring test decides WROOM-1 or WROOM-1U. hw_lib_build.py makes the cut, so a
    library rebuild keeps it. hw_sync.py now replaces footprints whose library copy changed, and
    hw_contract.py checks that U201's rule area covers the strip keep-outs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
2026-10-11 feat(hardware): draw the perch board and owl dock-pad schematics; perch ERC clean
2026-10-11 feat(hardware): lay out and route the perch board with the snap-off dock-pad section; perch DRC clean
2026-10-11 fix(firmware): hand a 401 on to the runtime and resend after a stale TLS connection
    ESP-IDF 6.1 fails every 401 inside esp_http_client_perform: it tries Basic
    or Digest auth, which are not built in, and returns ESP_ERR_NOT_SUPPORTED
    before the body is read. spotify_http_call now treats any failure after a
    status line as Spotify's answer with that status (P32), marks the body as
    cut and drops the connection, so the runtime's 401 refresh can happen.
    The host stand-in fails 401s the way IDF does.
    A stale kept-alive TLS connection comes back as ESP_ERR_HTTP_FETCH_HEADER,
    not CONNECTION_CLOSED, so that error is resent once too when the
    connection was reused and nothing was answered (P8 as amende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
2026-10-11 feat(enclosure): add perch v1 with the board pocket, screw bosses, owl seat and pogo pin stroke
2026-10-11 test(tools): drive the Spotify runtime on the Nano ESP32 against a real account, opt-in
2026-10-11 docs: describe the Nano ESP32 dev board, its Spotify console and the opt-in real-account test
2026-10-11 fix(tools): print hil_spotify's command outcome without a stray space
2026-10-11 fix(enclosure): trim the perch base flush with the rest back and join the J1 cavity to the pin window, no wall under 0.8 mm
2026-10-11 fix(hardware): straighten the USB pair, move C304 and C106 to their pins, put the holes on the front
    R203 and R204 stand below U201 pins 14 and 13 with their connector pads at the bottom, and U202
    turns to 180 so D+ runs above D- on both sides: the pair goes from J201 through U202 to U201
    without crossing (0 crossing airwires). C304 spans DRV2605L VDD pin 10 and GND pin 8, C106 sits
    at TPS63802 VIN pin 10 with C105 behind it, and L101's courtyard leaves the battery zone (R44).
    H1 to H8 are front in design.toml, as on the board (a bare hole has no side), and the side test
    covers them. mark_j101 removes only its own pin 1 dot. R102 3.6k synced from the schematic.
2026-10-11 fix(hardware): count 0.1 mm pad stand-off in the battery rule and test each contract rule
    Ruling R44: a part under the battery fails when its design.toml height plus 0.1 mm exceeds the
    1.2 mm limit. contract_errors() returns the error list, and the tests assert the exact lines for
    the battery rule on its own (1.1 mm passes, 1.15 mm fails) and for the Hall-sensor keep-out.
2026-10-11 fix(enclosure): check every part in the fit check, with boxes where a 3D model is missing
    Ruling R45: tools/hw/hw_export3d.py exports the STEP and lists each part kicad-cli has no model
    for (the EasyEDA models are gitignored) with its courtyard and design.toml height. fit_check.py
    extrudes those courtyards (height plus the 0.1 mm stand-off), uses the contract box for fixed
    parts, names both groups and refuses to run without the list.
2026-10-11 fix(tools): put the account back after a failed or interrupted hil_spotify run and check that prev returns to the first track
2026-10-11 feat(hardware): route the TPS63802 power loop
    tools/hw/hw_route.py draws the hand-routed groups as locked B.Cu tracks. The TPS63802 group: L1
    and L2 at 0.5 mm straight into L101 (necked to 0.3 mm at the 0.5 mm pitch pins, entering the
    inductor pads clear of its no-track area), VIN from pin 10 through C106 to C105 at 0.5 mm, EN to
    VIN below the package, VOUT from pin 6 through C107 to C108 at 0.5 mm, C109 and the top of the
    feedback divider from C107, FB from pin 4 to R107 and R108 on the side away from L1 and L2 (R107
    turned so its FB pad faces R108), GND pins 2, 3 and 8 joined between the pad rows. GND vias and
    the In1 tie come with the planes. DRC: no new violation type, 272 to 259 unconne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
2026-10-11 fix(firmware): fail the old account's waiting commands when a new login arrives
    Since commands can wait in the coalescing queue across passes, a login
    change could send them to the new account. The runtime now answers each
    of them with failed login_changed before it polls the new account, next
    to forgetting the token, the device numbers and the player. The console
    doc lists the new error and says that three vol +5 merge into one request
    only while another request is under way.
2026-10-11 feat(hardware): route the charger power paths and the fuel gauge Kelvin tap
    VIN_CHG from BQ24073 pin 13 to C101 and on to the D101 and D102 cathodes, VSYS from pins 10 and
    11 to C102 and TP102, VBAT from pins 2 and 3 to C103 and up past TP103, outside the H1 boss
    ring, to J101 pin 1: 0.5 mm, necked at the 0.5 mm pitch pins and 0.4 mm between C103 and R103.
    The MAX17048 CELL and VDD pins run on their own 0.25 mm trace to J101 pin 1 with C104 at pin 3
    (R37). U101's thermal vias wait for the In1 and In2 planes (on their own they are dangling).
    DRC: no new violation type, 259 to 246 unconnected.
2026-10-11 feat(hardware): route the USB pair from U202 to the ESP32-S3
    USB_DP_CONN and USB_DM_CONN run through U202 under its body, then as a 0.2 mm pair with 0.15 mm
    gap east, up a clear corridor at x 5.65/6.0 between the IMU and the TPS63802 divider, and into
    R203/R204 from below, D+ on the left of travel at every turn so the lines never cross; USB_DP and
    USB_DM are the short stubs to U201 pins 14 and 13. Lengths: D+ 62.6 + 2.5 mm, D- 64.2 + 4.9 mm
    (full speed, no matching needed). The J201 fan-out to U202 is left for the next session. DRC: no
    new violation type, 246 to 240 unconnected.
2026-10-11 test(firmware): pin that a connection the transport closed is fresh again
    The first request after spotify_http_close (a logout, the network going
    down) goes out on a new connection, so a FETCH_HEADER there is not sent
    twice (P8).
2026-10-11 feat(hardware): route the 32.768 kHz crystal
    U201 pins 8 and 9 run straight to Y201 (3.5 mm each, 0.15 mm), and on to the C204 and C205 load
    caps on the crystal's far side (1.9 mm). Nothing else runs between the crystal and the module;
    pins 7 and 10 have to escape another way when the rest is routed. hw_route.py also holds the
    dock group, routed in the next commit. DRC: no new violation type, 240 to 236 unconnected.
2026-10-11 feat(hardware): route the dock power and pad lines
    VBUS_DOCK runs from J303 pin 2 through the D301 TVS and up the right side, clear of the H4 boss
    ring and U301, to the D102 anode at 0.5 mm (29.6 mm). DOCK_PAD runs from J303 pin 3 through the
    D302 ESD diode to R307 (6.5 mm, 0.25 mm). DRC: no new violation type, 236 to 232 unconnected.
2026-10-11 feat(hardware): route the USB-C fan-out to the ESD array
    J201's D+ pads (A6, B6) drop to vias just above the pad row and its D- pads (A7, B7) to vias just
    below it; each pair joins on F.Cu over the solid In1 GND and comes back up beside U202 pins 6 and
    4 (0.2 mm, D+ 9.9 mm, D- 11.1 mm, three vias each). D- passes below the J201 peg hole and the
    through-hole shell tab. B.Cu above the pads stays free for CC1, CC2 and VBUS. The USB nets are now
    fully connected from J201 to U201. DRC: no new violation type, 232 to 228 unconnected.
2026-10-11 fix(hardware): put the perch mouse bites on the neck edges and move J1 1.5 mm down for a full-size USB-C plug
2026-10-11 fix(enclosure): fit the full-size USB-C overmold, relieve both pockets for the neck nub, and tie perch_v1 to the board
2026-10-11 fix(tools): tag each hand-route group so a re-run removes its old copper
    hw_route.py now puts a group's tracks and vias into a KiCad group named
    "hw_route <group>", and a re-run deletes everything in that group before
    drawing again, so edited coordinates leave no stale locked copper (review
    M3). Untagged copper at the group's exact coordinates is still replaced.
    Items are removed with Board.Delete: Board.Remove gives the C++ item to
    its Python wrapper, and once that wrapper is freed the board's track list
    stops being iterable in KiCad 10.0.6, which broke a re-run halfway.
    All seven part A groups were re-run to tag their 109 items; the copper is
    unchanged.
2026-10-11 feat(hardware): route the QSPI display bus and LCD_TE to J301
    LCD_CLK, LCD_CS and LCD_D0 to LCD_D3 run from the module's FSPI IO_MUX
    pins (B.Cu) to J301 (F.Cu) at 0.1 mm with one via each and no track
    between J301's pads. D2, CLK and D0 turn west, run down the back under
    J301 and come back east below it, which reverses their order for the
    bottom row; D1 drops to F.Cu at the module and CS crosses under it on
    B.Cu, as in the review's routing plan. A D1 serpentine and CS and D3
    trombones bring the lengths to 13.7 to 16.1 mm (LCD_CLK 16.1 mm). LCD_TE
    leaves the module's left column and reaches its pad on F.Cu.
    GND vias sit beside each layer change; two of them also feed J301 GND
    pins 10 and 20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
2026-10-11 fix(hardware): tie the TPS63802 input and output caps to the GND planes
    The VSYS and +3V3 runs fence the GND pads of C105 to C108 off from the
    TPS63802 GND pins on B.Cu, so the input and output loops have to close
    through vias into In2 GND, which stays GND under the part, and In1
    (review I1). Ten 0.3/0.5 mm GND vias: one beside each GND pad of C105 to
    C109, two in the channel between U103's pad rows, two west of pins 2 and
    3, and one at R108's end of the feedback divider. Each is joined to its
    pad by a short stub, so no via sits in a pad. DRC: no new violation
    type; the vias show as via_dangling (17 in all) until the planes exist.
2026-10-11 fix(firmware): send Web API requests that have no body
    ESP-IDF 6.1 answers ESP_ERR_NOT_FOUND when esp_http_client_set_post_field
    drops a Content-Type header that was never set, and the owl took that as a
    failed request. Every GET, and every command without a body, failed before
    it left the board, so the owl never read the playback state and backed off.
    The host fake now answers like ESP-IDF 6.1.
2026-10-11 fix(tools): wait for the owl to come online before the real-account test
    Opening the port restarts the Nano ESP32, so the first hello came before
    it had joined Wi-Fi and the test failed at its first check.
2026-10-11 fix(hardware): keep the charger's paste off its open thermal vias
    U101 (BQ24073 RGT) now uses a project copy of KiCad's ThermalVias
    footprint, owltunes:VQFN-16-1EP_3x3mm_P0.5mm_EP1.6x1.6mm_ThermalVias_Drill0.3,
    built by hw_lib_build.py: the four vias at the corners of the 1.6 mm
    exposed pad are opened from 0.2 to 0.3 mm and stay open (no plugging),
    and the stock paste windows, which sat over the vias, are redrawn round
    them (review I2). A 1.5 x 0.6 bar and two 0.6 x 0.35 arms keep 0.1 mm
    from each drill, touch no 0.5 mm via pad and print 51.6 % of the pad
    (TI's guidance for RGT is roughly 50 to 80 %). The via grid moves from
    0.8 to 1.1 mm pitch: at 0.8 mm no window layout clear of the vias g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
2026-10-11 feat(hardware): route the VIN_CHG taps to TP101 and R103
    TP101 hangs off the D101/D102 cathode run at 0.5 mm, passing above the
    diode anodes so D101's VBUS_USB anode can still be reached from the east
    and from below TP101. R103, the CHG_EN2 pull-up, sits between the VBAT
    and VSYS runs north of U101, so its tap crosses on F.Cu west of U101
    with a via at each end, clear of the area below U101 pin 1 that BAT_NTC
    will use. DRC: no new violation type, 222 unconnected.
2026-10-11 feat(hardware): route TPS_PG from the TPS63802 to R212
    U103 pin 5 drops to a via in the pocket west of the pin, inside the +3V3
    and feedback runs, then runs 36 mm on F.Cu, east of the crystal and its
    load caps so nothing sits on F.Cu under them, to a via beside R212 on the
    ESP32 EN network. DRC: no new violation type, 221 unconnected.
2026-10-11 feat(hardware): tie the part A caps, charger, gauge and ESD parts to GND
    GND for the hand-routed parts whose GND pads a pour cannot reach
    directly or that need a short path to the planes (Step 1 item 5). U101's
    GND pins 4 (boxed in by VBAT, review focus answer 2), 8 and 15 run
    0.2 mm into its exposed pad and thermal vias; U102's pins 4 and 6 into
    its pad, which gets a via on its west side, outside the paste. One via
    beside each GND pad of C101 to C104 and of the crystal load caps C204
    and C205. The USB ESD array's GND pin, boxed in by the USB lines, drops
    through a via under its body; the D301 TVS gets two vias and the D302
    ESD diode one. DRC: no new violation type, via_dangling 28 (all GND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
2026-10-11 fix(hardware): run VBAT at 0.5 mm past C103 and R103 and branch at vertices
    The VBAT run between C103 and R103 and the TP103 spur are now 0.5 mm
    (review M1). A straight 0.5 mm run at x 21.75 would come 0.18 mm from
    R103, so it steps to x 21.65 above C103: 0.225 mm from C103's GND pad
    and 0.28 mm from R103. The run up from C103 now starts at a vertex of
    the 0.5 mm polyline from U101 (the old tee at its midpoint), and the
    TP103 spur at a vertex of the run (review M2). Re-running the charger
    group with these coordinates left none of the old copper behind. DRC:
    no new violation type, 216 unconnected.
2026-10-11 fix(web): lower RTS before DTR so connecting does not restart the owl
    Chrome applies each line on its own, and DTR low while RTS is still high
    is the ESP32-S3 USB-Serial/JTAG reset request: every connect restarted
    the Nano ESP32 and the page met an owl that had just lost its Wi-Fi.
2026-10-11 fix(tools): leave the port with blocking reads when a script closes it
    pyserial sets VMIN to 0 and Linux keeps it after the port closes. Chrome's
    Web Serial then took an empty read for a lost device, so the setup page
    dropped the owl right after any hardware script had used the port.
2026-10-11 fix(tools): delete, not remove, board items in hw_sync and hw_place
    Board.Remove in KiCad 10.0.6 hands the C++ item to its Python wrapper.
    Once that wrapper is freed, pcbnew's bindings return untyped
    SwigPyObjects for every board, as part B found in hw_route.py. hw_sync.py
    (removed and replaced footprints) and hw_place.py (the J101 marks) now
    use Board.Delete; the mark removal is its own function so it can be
    tested.
    Each tool gets a test that runs it in a fresh interpreter and then loads
    the board there. Both fail with Board.Remove and pass with Board.Delete.
2026-10-11 docs: say what restarts the Nano ESP32 on a port open, and why the setup page can lose it
    Measured on the board: DTR low while RTS is high restarts the chip, an
    open alone does not, and a port left at VMIN 0 by pyserial makes Chrome's
    Web Serial report the owl as disconnected.
2026-10-11 feat(hardware): put a 10k NTC on the board and make J101 a 2-pin JST PH
    Cheap 803040 packs are 2-wire with a JST PH 2.0 plug, and the BQ24073
    does not charge with TS open. J101 becomes the 2-pin S2B-PH-SM4-TB
    (C295747; pin 1 VBAT, pin 2 GND) and RT101, a Murata NCP15XH103F03RC
    (C77131, 10k 1 %, B25/50 3380 K, B25/85 3434 K: the 103AT-2 curve the TS
    thresholds assume), goes between BAT_NTC and GND. No 10k NTC is Basic or
    Preferred at JLC, so it is Extended.
    hw_sync.py swapped J101 in place at its contract position and added
    RT101; hw_place.py puts RT101 on the back under the cell at (-4, -9.5),
    30 mm from U101, and draws + and - with a pin 1 dot beside J101's two
    pins (the stale NTC mark goe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
2026-10-11 feat(hardware): route BAT_NTC to the board NTC and J101's return to GND
    New hw_route.py group bat_ntc: U101 pin 1 (TS) on B.Cu to a via
    south-west of C103, F.Cu over In1 GND across the B.Cu USB pair, and a
    via in RT101's patch under the cell. Pad 1 joins the 4.5 x 3 mm patch
    through a 0.6 mm, 0.3 mm neck; pad 2 reaches its own GND via through a
    1.5 mm, 0.2 mm neck. A DRU rule keeps the pours off RT101's pads, so the
    NTC is not tied straight into the B.Cu GND pour that spreads the
    charger's heat, and each pad of the 0402 sees a narrow neck at reflow.
    J101 pin 2 (the battery return) gets two 0.4 mm stubs and vias beside
    its pad, just outside the housing (gnd_vias group).
    The stale hw_route.p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
2026-10-11 test(tools): say that U101's paste windows are tangent to the via pads
    The test said no opening may touch a via pad, but its assertion passes at
    exact tangency, and the footprint is exactly tangent (review M4). The
    test now asserts what the footprint does, 0.1 mm from every drill, which
    is the 0.5 mm pad's edge, and the test, hw_lib_build.py and the library
    README all say the windows are tangent to the pads and overlap none.
2026-10-11 docs(hardware): a 2-wire pack and the board NTC in rev-a, assembly and bring-up
    The pack is any 2-wire 803040 with a protection circuit and a JST PH 2.0
    2-pin plug; the statement that it needs a 10k NTC wire and the 10k
    resistor workaround are gone. rev-a.md gives the TS cut-offs on the
    NCP15XH103 curve (B25/85 3434 K, Murata's R-T table): charging stops
    above 51.2 C and below -0.5 C (47.1 to 55.7 C and -2.5 to 1.6 C over
    the BQ24073's VHOT, VCOLD and bias tolerances), and says RT101 reads the
    board under the cell, so the window is approximate and runs a few
    degrees warm in fast charge. The battery NTC goes into the table of
    deviations from the spec, and bring-up compares RT101 with a
    thermo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
2026-10-11 feat(hardware): make RT101 a B25/50 3950 K NTC and recompute the TS cut-offs
    Controller ruling: RT101 becomes Sunlord SDNT1005X103F3950FTF (C95939, 10k, 1 % on R25 and on
    B, B25/50 3950 K, 0402, JLC Extended, stock 184396; no Basic or Preferred 10k NTC exists). The
    alternate is KUU KNTC0402/10KF3950 (C41366926), also 3950 K at 1 %. Height 0.65 mm (0.5 +- 0.15).
    The steeper curve narrows the BQ24073 charge window from the 103AT-2's 0 to 50 C to 47.2 C hot
    (release 44.7 C, worst case 43.2 to 51.5 C) and +3.5 C cold (release 6.5 C, worst case +1.4 to
    +5.6 C), from VHOT, VCOLD and INTC in SLUS810N 8.5 and RT101's own tolerances. rev-a.md,
    bringup.md, design.toml and the power sheet note carry t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
2026-10-11 docs(hardware): review the perch dock board and record its fabrication outputs
2026-10-11 docs(hardware): add the thermal gap pad at RT101 to the off-board parts
    A soft silicone gap pad, about 5 x 5 mm, 1.5 mm thick, 1 to 3 W/mK and electrically insulating,
    bridges the 1.2 mm battery gap between RT101's copper patch and the cell so the cell, not only
    the board, sets RT101's temperature. rev-a.md gets an "Off-board parts at the battery" section
    (the pack and the pad, with where the pad goes); assembly.md lists the pad and places it in step
    8 before the cell goes in. The bring-up open item now measures RT101 with the pad fitted.
2026-10-11 fix(tools): hw_fab verify proves each part once, matches the plated drill and reports a missing lcsc
2026-10-11 fix(tools): hw_fab reports unassembled parts whose symbol or footprint is not excluded instead of promising to edit schematics
2026-10-11 feat(hardware): keep the pours off RT101's GND neck and In2 off its patch
    Review M1: a GND pour floods a GND track, so the B.Cu pour took RT101's pad 2 neck right up to
    the pad, and the DRU rule only kept it off the pads. hw_route.py can now draw no-pour rule
    areas (tracks, vias, pads and footprints allowed) as part of a group, and bat_ntc draws two:
    - B.Cu: 0.4 mm round RT101's pads and round the patch, and 0.3 mm either side of the pad 2 neck
    down to 0.05 mm short of its GND via.
    - In2: under the patch. Only BAT_NTC itself crosses that area on F.Cu or B.Cu.
    A test pour on a copy (KiCad 10.0.6 fill, 0.2 mm GND zones on B.Cu and In2) leaves a 1.49 mm
    free neck (pour joins it at y -11.31,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
2026-10-11 fix(tools): clear only hw_place's own J101 marks
    Review M3: clear_j101_marks deleted every back silkscreen text and dot whose anchor lay beside
    J101's pins, so a label or fab mark placed there later would vanish on the next hw_place run. It
    now deletes only the texts it draws ("+", "-") and the 3-pin J101's "NTC" inside the mark area,
    and the pin 1 dots at the 2-pin and 3-pin positions. A new fresh-interpreter test pins the
    boundary: the same texts 0.05 mm outside the area, another text and another dot inside it stay,
    and the old pin 1 dot goes.
2026-10-11 fix(hardware): drop the board-wide 0.09 mm clearance rule so net classes apply
    The DRU rule "JLC 4-layer minimum clearance" had no condition, so it overrode every net class
    and zone clearance: a 0.2 mm zone filled to 0.091 mm from Default and Power copper, and DRC
    checked everything against 0.09 mm. The .kicad_pro already keeps 0.1 mm as the board minimum.
    Without it DRC exposes no clearance fault in the hand-routed copper (parts A, B and N). It does
    flag five pairs inside U303 (LIS2DW12, LGA-12 2 x 2 mm, 0.5 mm pitch): its 0.35 mm pads are
    0.15 mm apart, below the Power class's 0.2 mm next to the +3V3 and GND pads. A new rule allows
    0.15 mm only between two of U303's own pads. DRC is back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
2026-10-11 fix(hardware): join U101's thermal via pads to the planes solid
    The four 0.3 mm via pads of the charger's exposed pad had no zone
    connection of their own, so the planes would have reached them through
    thermal reliefs. The planes are the BQ24073's heat path, so qfn_copy now
    writes zone_connect 2 on them (as on the exposed pad), the library test
    asserts it, and the board's U101 pads carry the same setting.
    KiCad's lib_footprint_mismatch check does not compare pad zone
    connections (a copy of the old board against the new library reports no
    mismatch), so the board pads were set directly rather than re-synced;
    DRC reports no mismatch either way.
    Part B review M1.
2026-10-11 fix(hardware): drop the unconditioned DRU rules that hid the perch net class clearances
    perch-dock.kicad_dru had "JLC 2-layer minimum clearance" (min 0.127 mm)
    with no condition, which overrode the Default (0.2 mm) and Power
    (0.25 mm) clearances and the pours' own: the stored GND fill sat 0.127 mm
    from VBUS_IN, VBUS_OUT and the signal tracks. Without it, DRC shows 65
    clearance errors against the old fill; after a refill only the 8 pad
    pairs inside J1 remain (the HRO TYPE-C-31-M-12 has its VBUS and GND pads
    0.2 mm apart). A rule limited to J1's own pads keeps that gap; tracks and
    pours keep the classes'. The board is refilled and saved: the GND pour
    now keeps 0.250 mm from the Power nets on b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
2026-10-11 feat(hardware): route VSYS to the TPS63802, the +3V3 feed to the module and VBUS_USB by hand
    Three new hw_route.py groups, all 0.5 mm, locked and grouped, before
    Freerouting takes the rest:
    - vsys_link: the charger's VSYS copper is sealed in on B.Cu and In2 stays
    GND under U101, U103 and their caps, so VSYS crosses on F.Cu over In1:
    two vias at C105 (the bulk input cap), north between U103's west and
    channel GND vias, east between the channel and C109 vias, north west of
    the C107/C108 vias (clear of L101 and the switch pins), east at y 3.25,
    two vias on the charger's VSYS run. 30.0 mm.
    - v3v3_feed: C108 to two vias west of the TPS_PG run, F.Cu up at x 7.0
    to two vias under the m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
2026-10-11 feat(hardware): pour the In1 and In2 planes from hw_route.py
    hw_route.py groups can now draw copper pours, (net, "pour", polygon,
    layer, priority): 0.2 mm clearance, 0.2 mm minimum width, thermal reliefs
    with a 0.3 mm gap and 0.3 mm spokes, islands removed, locked and in the
    group's KiCad group, so a re-run replaces them; a run that draws a pour
    refills every zone. A new test draws, fills and replaces pours on a
    4-layer test board (it fails on the previous hw_route.py).
    The planes group: In1 solid GND; In2 GND everywhere except a +3V3 pour
    under the module inside its pin ring (x -8.4 to 8.4, y 18.8 up to the
    antenna rule area at 36.6). The pour starts above the bottom pin row, so
    the QSPI a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
2026-10-11 feat(enclosure): deboss the owner mark into the owl back cover
    "Tyukov Inc" in Inter Bold, 5 mm cap height, 0.5 mm deep in the back
    cover's outer face, centred left to right at the display centre's
    height and reading from behind. The plate under it stays 1.0 mm.
    Each glyph is closed by 0.3 mm, which fills the 0.33 mm notches where
    Inter's n and u arches meet their stems, and the letters are spread
    0.15 mm, so every stroke, notch and letter gap is at least 0.6 mm (MJF
    detail limit). The text constants live in owl_params.py; CI installs
    fonts-inter for the font.
2026-10-11 feat(enclosure): deboss the owner mark into the perch underside
    "Tyukov Inc", the same 5 mm Inter Bold mark as the owl, 0.5 mm deep in
    the underside's left strip beside the weight pocket (the USB channel is
    on the right). It reads front to back with the letter tops towards the
    pocket, 2.8 mm from the base's side and from the pocket, and leaves
    7.1 mm at each end of the strip for the silicone feet (FOOT_ZONE 6.0).
2026-10-11 fix(enclosure): convert the owner mark to B-splines so its STEP reads back
    Closing the glyphs leaves offset curves. The STEP files written from
    them read back with no solid (back cover) or two fragments (perch), so
    the mark outlines are converted to B-splines before the cut. The export
    tests now read every STEP back and compare solids and volume.
2026-10-11 fix(enclosure): slot the LRA cup wall for the motor's lead tab
    The LD0832AA-0099F lead tab reaches 5.75 +-0.1 mm from the motor centre
    at the mounting face, up to 3.5 mm wide with UV glue up to 2.5 mm high
    (specification page 13), and the closed cup wall spanned r 4.15 to
    5.15. A 4.0 mm slot now cuts the whole wall at 185 degrees, the
    direction closest to J302's plug that keeps the tab 1.0 mm from the
    dock magnet boss and 1.6 mm from the board-mount boss. The remaining
    302 degrees of wall still hold the motor.
2026-10-11 feat(tools): draw each board's own silkscreen marks and keep references clear of them
    tools/hw/hw_silk.py draws a board's name, owner mark, licence, date,
    JLC order-number mark, connector and test pad labels and extra pin 1
    marks from data (owl frame, KiCad x - 100, 100 - KiCad y), back side
    text mirrored, all in a "hw_silk" KiCad group that a re-run replaces
    (Board.Delete, with a fresh-interpreter test). A test checks that every
    mark meets JLC's 0.8 mm / 0.15 mm (1.0 mm for "Tyukov Inc"), that both
    boards carry the owner mark and that JLCJLCJLCJLC is on the main board's
    back.
    hw_place.py's reference placement now also keeps clear of every
    footprint silkscreen drawing and every board silksc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
2026-10-11 feat(hardware): keep routes from between J301's pads and route its fan-out and DISP_3V3 by hand
    The first full Freerouting run put DISP_3V3, GND and LCD_RST tracks
    between J301's two rows. hw_route.py gains ("", "keepout", polygon,
    layer) rule areas (no tracks, vias or pours; pads allowed), and the qspi
    group now draws one on F.Cu over the band between J301's rows and the
    0.3 mm gaps between neighbouring pads (j301_comb). The Specctra export
    hands it to Freerouting as a keepout. The rule-area test covers it.
    New groups, locked and grouped:
    - j301_fanout: every remaining J301 pin led out of the connector. Top
    row pins leave upwards to vias west of the B.Cu QSPI lanes (TP_SCL,
    TP_RST, GND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
2026-10-11 feat(hardware): route the remaining main board nets with Freerouting
    Freerouting 2.4.1 (Java 25, headless, analytics off) on KiCad's Specctra
    export, prepared so that it routes only on F.Cu and B.Cu: In1 and In2
    as power layers without the plane polygons (as signal layers it put
    tracks on them; as power layers with the planes it fanned nothing out
    to them; its autoroute_settings layer rules break the DSN load in
    2.4.1), and the Power class at 0.25 mm since the 0.5 mm paths are hand
    routed and fixed. Settings: -mp 40, via cost 30 (default 50) so nets
    hop the 45 mm B.Cu USB pair with two vias (9 F.Cu crossings), hole
    clearance 0.26 mm, copper to edge 0.32 mm, fan-out off. 254 items to
    route, 7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
2026-10-11 fix(enclosure): add a cable relief in the bottom wall behind J303
    J303's mated JST SH plug ends about 0.8 mm from the body's bottom wall,
    which leaves the wires little room to turn. Behind it the wall's inner
    face is set back 0.6 mm, which still leaves 1.0 mm because the owl
    stands on this wall on the perch seat. The relief is 8.0 mm wide (the
    7.0 mm SHR-04V-S-B plus 1.0), centred on J303's x, and runs 4.0 mm down
    from the board's back face. It follows the silhouette into the corner,
    so the wall left is 1.0 everywhere, and it does not use J303's y.
2026-10-12 feat(hardware): pour the outer GND, stitch the edge and finish the routes Freerouting left
    hw_route.py groups:
    - outer_pours: GND on F.Cu and B.Cu over the whole board (0.2 mm
    clearance, thermal reliefs), drawn after the Freerouting import.
    - stitching: 68 GND vias about every 3 mm on a line 0.75 mm inside
    the edge (R5) and along the antenna notch's lower edge under the
    module; spots against other copper, any pad, a mounting hole or under
    J201 are left out.
    - local_power: the fine-pitch power pins Freerouting could not reach
    with the Power class's 0.2 mm clearance. U303: +3V3 pad 2 to R309 and
    across under the LGA to pads 9, 10 and C307, plus a GND via for its
    GND pads (a pour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
2026-10-12 feat(hardware): join the two +3V3 islands Freerouting left to the TPS63802 output
    Freerouting's +3V3 ended in three groups. The new late_links group in
    hw_route.py joins them by hand:
    - the west group (U104 pin 1, C110, R206, R207, R210, R211, R304 to
    R306, R309, U302, U303, C306 to C308, J202): a via beside R306's
    +3V3 pad, F.Cu east at y 27.5 over the module's left column (below
    DOCK_DET's F.Cu run) and a via into the In2 +3V3 pour under the
    module;
    - the U301 group (U301, C304, C305, R105, R106, R308): F.Cu from its
    via at (26.28, 2.22) west at y 2.5 to a via beside TP104 on the
    TPS63802 output. vin_chg_taps' top via moves from y 2.2 to 1.8 so
    that run fits between it and th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
2026-10-12 feat(hardware): route the last two I2C_SDA links by hand
    Freerouting left U304 pin 6 and U102 pin 8 off the bus. Both links are
    hand copper in hw_route.py late_links:
    - U304 pin 6 runs F.Cu west above ESP_EN's run and over the +3V3 vias at
    x 7.3, then B.Cu under the module to the SDA run from pin 35.
    - U102 pin 8 runs F.Cu north round CHG_PGOOD's via, south at x 20.5, hops
    under the VSYS and +3V3 F.Cu runs on B.Cu and joins the bus via at
    (19.929, -11.292) on the U301 side.
    Three Freerouting GND tracks under the module that crossed the first path
    are deleted; the B.Cu pour joins those module pads. DRC: 0 unconnected,
    0 parity, only the Task 8 silkscreen warnings left.
2026-10-12 feat(hardware): add GND return vias beside the J201-side USB vias
    The USB pair changes reference from In2 to In1 at the vias next to J201,
    and the nearest GND through-connection was the shell tab 3.6 mm away
    (Step 1 review M6). One GND via now sits above the two D+ vias and one
    below the two D- vias; at the U202 end the shell tab is beside the vias
    already. DRC unchanged: 0 unconnected, 0 parity, silkscreen warnings only.
2026-10-12 feat(hardware): draw the main board silkscreen and clear its warnings
    hw_silk.py draws the main board marks on B.Silkscreen: OwlTunes rev A,
    Tyukov Inc (1.0 mm), the licence and date, JLCJLCJLCJLC for the order
    number (0.8 mm, under the cell), DOCK, EXP, LRA, RESET, BOOT, TX, RX and
    a dot beside U201 pin 1; on F.Silkscreen 1 and 31 at J301. hw_place.py
    then moves the reference designators clear of every silkscreen item and
    hides the 40 it has no room for; no part moved.
    The six silk_overlap warnings from Task 8 are gone. The three
    silk_edge_clearance warnings are correct by design and are excluded with
    a comment in the project file: J201's library outline runs to the
    receptacle front, which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
2026-10-12 ci(hardware): enforce DRC on the main board
    owl-mainboard now passes DRC with 0 violations, 0 unconnected items and
    0 schematic parity errors, so boards.toml turns its drc flag on and
    check_all.sh fails CI on any regression. The three accepted
    silk_edge_clearance warnings (J201's receptacle outline and U201's pin 1
    triangle, both past the board edge by design) stay excluded in the
    project file with their reasons.
2026-10-12 fix(hardware): put a GND via within 1 mm of every USB via and refill the pours
    kicad-happy (analyze_pcb, cross_analysis, analyze_emc, analyze_thermal)
    on the routed board. Fixed:
    - RP-001 on USB_DP_CONN and USB_DM_CONN: the D- return via at J201 moves
    to 0.94 mm from both D- vias, and two GND vias go beside the U202-side
    vias (0.81 and 0.96 mm); they are also U202's second ground via (ES-002).
    - The zone fills saved in the board were stale after the late hand links;
    all zones are refilled and saved (KiCad orders the DRC exclusions).
    Judged false positives or accepted by design:
    - PS-002 (+3V3, VBAT, VSYS "plane" islands): no such planes; KiCad's
    connectivity has 0 unconnected. The a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
2026-10-12 feat(hardware): move J303 up 1.175 mm to give the dock cable room to bend
    Controller ruling: the partial move. J303 goes from owl y -32.0 to
    -30.825 in the enclosure contract (contract.json regenerated): its
    courtyard top now sits on the battery zone's edge at y -27.5. At -30.82
    it would reach 0.005 mm into the zone and fail the contract check. The
    mated plug's cable gets about 2.0 mm to bend before the body's bottom
    wall (inner face y -37.4), up from 0.8 mm.
    - D301 moves up 0.2 mm (y -26.2) to clear J303's courtyard.
    - hw_route.py dock: VBUS_DOCK and DOCK_PAD start at the new pins;
    DOCK_PAD runs at y -27.4, below D302's GND pad. gnd_vias: D301's GND
    stubs follow its pad to the same two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
2026-10-12 fix(hardware): delete the session copies that overlap hand copper
    Review M1: three spots where the Freerouting import left unlocked copper
    on top of locked hand routes.
    - C202's GND pad to module pin 1: Freerouting's three-segment path
    (8.75, 35.61) to (9.827, 35.61) to (9.827, 35.253) to (10.3, 34.78)
    ran over local_power's own link; all three segments go.
    - +3V3 B.Cu (22.85, -13.0) to (23.22, -13.0), inside local_power's run
    to U301 pin 10; the Freerouting diagonal from (23.22, -13.0) still
    ends on that run.
    - A zero-length GND segment at U101 pin 15 (24.25, -1.438).
    DRC 0 violations, 0 unconnected, 0 parity. KiCad's save reorders the
    DRC exclusions in the project file.
2026-10-12 feat(hardware): join the enclosed outer pour regions with GND vias
    Review M2: regions of the F.Cu and B.Cu GND pours closed in by tracks
    had no GND via, so the filler dropped them as islands. The new
    pour_vias group in hw_route.py puts one GND via (0.5/0.3 mm) at the
    deepest spot of each region of 4 mm2 or more that is outside every
    courtyard and clear of other copper on both outer layers; the region
    beside the module's exposed pad gets its via under the module. Ten vias:
    three for F.Cu regions (117, 15 and 9 mm2), seven for B.Cu (178, 88,
    73, 53, 9, 5 and 5 mm2).
    GND pour coverage of the board: F.Cu 79.5 to 82.5 %, B.Cu 63.1 to
    72.1 %; In1 93.9 % and In2 87.1 % GND plus 6.0 % +3V3, unchang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
2026-10-12 fix(hardware): keep the board name out from under the H2 cover boss
    Review M3: "OwlTunes rev A" ran 4.5 mm into the H2 cover boss
    keep-out (r 3 at (-19, 9)), where the back cover's boss would hide it.
    The block now reads Tyukov Inc (moved left of the boss, at (-26, 7)),
    OwlTunes rev A (y 5.0, below the boss), the licence and the date as
    before; both moved lines keep 0.36 mm from the circle, all stay above
    C306 and U302.
    hw_silk.py checks it: on a board with a contract.json, a run fails and
    saves nothing if any mark's strokes overlap a boss keep-out circle on
    its side (cover bosses on the back, body bosses on the front). Tests:
    a mark under a boss on its side fails on either side and leaves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
2026-10-12 test(tools): guard the DRC exclusions and the DRU rules of both boards
    Review M5: hw_kicad.py drops excluded markers, so an exclusion added in
    the GUI for a clearance, unconnected or parity marker, or a new
    unconditioned clearance or track width rule, would pass CI; both were
    real mistakes earlier in rev A. test_hw_rules.py fails if any exclusion
    in owl-mainboard.kicad_pro or perch-dock.kicad_pro is not a silk_*
    marker or has no comment, or if any rule in either .kicad_dru sets a
    clearance or track_width constraint without a condition (the U303 and
    J1 pad rules have one). Two cases on synthetic inputs show the checks
    catch each kind of mistake.
2026-10-12 feat(hardware): label the power test pads on the back silkscreen
    Review M6: bring-up probes TP101 (VIN_CHG), TP102 (VSYS), TP103 (VBAT)
    and TP106 (GND) first, and their references are hidden. hw_silk.py now
    writes VIN, VSYS and VBAT above the first three and GND below TP106,
    0.8 mm high with the 0.15 mm stroke, each centred about 1.45 mm from
    its own pad and nearer to it than to any other test pad, clear of pads,
    holes, footprint silkscreen, the other marks, the boss keep-outs and
    0.5 mm inside the edge. All four fit.
    hw_place.py re-ran: R103's and R106's references give way to the VBAT
    and VSYS labels, so 42 references are hidden now (was 40).
2026-10-12 docs(hardware): review the main board on its fabrication files
    Verdict ready, no blockers. ERC 0, DRC 0/0/0 with parity, fills current, hw_fab 0 errors
    (6 top, 81 bottom placements), Gerbers complete at 61.8 x 79.8 mm. Every kicad-happy finding
    is triaged, every IC's pads are checked against its datasheet pin table with pages, and the
    accepted risks for the order are listed: the FPC paper check, the TPS63802 channel vias, slow
    nets over the In2 +3V3 boundary, JLC-added fiducial rails and the rotation preview.
2026-10-12 docs(hardware): write the rev A ordering guide
    One order session before 28 October 2026: the order-day checks, the JLCPCB settings for both
    boards (5 bare, 3 assembled each; JLC-added fiducial rails, tab-routed), the JLC3DP list with
    both ring variants and both magnet carriers while the ring test is pending, and the parts that
    are not on the boards. No prices; a private order package is kept outside the repository.
2026-10-12 fix(hardware): set the JLC rotation offsets the EasyEDA footprints call for
    Each assembled part's EasyEDA footprint (JLC's placement zero) was matched pad by pad with
    the KiCad footprint on the board. The Fabrication Toolkit writes a bottom rotation as 180
    minus the KiCad rotation (the rotation seen from below, board turned over left to right,
    true for all 81 bottom parts) plus its own table rotation, so a part needs the
    EasyEDA-to-KiCad angle less the table's angle. Five parts get an FT Rotation Offset:
    - D101, D102 (PMEG2020EH, C456104): 180. EasyEDA's footprint has pad 1, the cathode, on
    the right at zero; KiCad's D_SOD-123F has it on the left. No toolkit rule. CPL 180 -> 0.
    - J101 (S2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
2026-10-12 docs(hardware): assemble with the ordered LRA pigtail and 803030 pack
    The order buys pre-crimped JST SH 2-pin pigtails for the LRA and a 2-wire 803030 class pack
    (efaso 803030 740 mAh, or EEMB 803030 700 mAh with a confirmed PH 2.0 plug), so:
    - assembly.md: no crimp tool; the motor leads are soldered to the pigtail under 1.5 mm heat
    shrink (red to pin 1); the battery step names the packs and keeps the polarity check against
    J101 (pin 1 VBAT, pin 2 GND) for every pack; the stack step places the 8 x 30 x 30 mm cell lead
    end up in the 803040 cavity against an end stop of 1 mm foam tape on the cover, and keeps tape
    off the cell's faces (8 mm cell in a 9.2 mm layer with up to 1.1 mm parts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
2026-10-12 docs: name the Chrome 156 fix for the lost-device page and drop the replug advice
2026-10-12 docs: explain that the tools restart the Nano ESP32 on purpose by lowering DTR first
2026-10-12 fix(hardware): move the CPL points of U201, J201 and the perch J1 to JLC's origins
    The Fabrication Toolkit puts an SMD part's CPL point on the KiCad footprint's anchor; JLC places
    its EasyEDA footprint by that footprint's origin. Fitting every assembled part's EasyEDA
    footprint onto the board pads by pad number puts the two within 0.075 mm for all parts but
    three, where the KiCad anchor is the body centre and EasyEDA's origin is near the pad pattern's
    centre:
    - U201 (ESP32-S3-WROOM-1, C2913202), bottom, KiCad rotation 180: EasyEDA origin at owl
    (0, 26.723), anchor (0, 30.35). The toolkit turns a bottom offset (x, y) at 180 into (-x, y),
    so FT Position Offset "0,-3.627". CPL (0, 30.35) -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
2026-10-12 docs(hardware): order the ring test's plastic bearing and glue, and name the M4 board
    ring-test.md's acceptance rule compares ring A with a steel and with a plastic 6710 bearing, so
    the off-board list gains one 6710 plastic bearing (POM races, glass balls) and the
    cyanoacrylate glue. The RSSI runs (M4) use an assembled main board, whose WROOM-1 PCB antenna is
    the board ring-test.md asks for.
2026-10-12 docs(hardware): settle the review's minor order notes
    - The bottom-side rotation convention is one decision: if JLC turns bottom parts the other way,
    all seven polarised bottom parts at 90 or 270 (U104, U202, U301, U303, J101, J202, J302) are
    180 off together; ordering.md gives the seven new rotation_offset values.
    - An offset is dropped by setting it to 0 (or "0,0"), not by deleting it: hw_sync.py only sets
    fields, so a deleted field would stay on the footprint.
    - Perch board: "Remove order number: No", since the board is hidden in the perch body and the
    pad section behind the back cover.
    - The order remark asks for no rail tabs at J201, SW203, SW201 and SW202.
    - design.toml's batte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
2026-10-12 fix(hardware): set the charge current to at most 0.5 C of the 700 mAh pack
    Controller ruling: the BQ24073 fast-charge current may not exceed 0.5 C of the EEMB 700 mAh
    fallback pack, 0.35 A. ICHG = KISET / RISET with KISET 797, 890, 975 A-ohm (SLUS810N p. 13);
    with KISET at 975 and the resistor 1 % low, RISET must be at least 975 / 0.35 / 0.99 = 2.81k.
    JLC lists 2.8k (C62741), 2.87k (C113479), 2.94k (C25886) and 3k (C25784) as Extended; the
    nearest Basic value at or above is 3.3k, 0402WGF3301TCE (C25890, 1986011 in stock).
    R101 2k (C4109) -> 3.3k (C25890): ICHG 0.270 A typical, 0.239 to 0.298 A (0.43 C of 700 mAh,
    0.40 C of 740 mAh at worst); precharge 27 mA, termination about 27 mA. ICHG is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
2026-10-12 docs(hardware): correct the main board BOM row count to 45
    The JLC BOM has 45 rows for 43 LCSC numbers: J202 and J303, and SW201 and SW202, share an LCSC
    number but carry different values, so the toolkit keeps them in separate rows. The review and
    ordering.md said 43 rows.
2026-10-12 docs(hardware): follow ruling R14 for the ring test instead of a plastic bearing
    Ruling R14: no plastic 6710 is bought (no seller of a 50 x 62 x 6 part was found either). Ring A
    uses the steel 6710ZZ and ring B, the printed bushing, is the metal-free option if the steel
    bearing costs too much RSSI; RSSI is measured relative, with and without the ring stack, on the
    owner's Nano ESP32 (NORA-W106, PCB antenna).
    - ordering.md: the plastic bearing row added in be2acba is removed; the note under the off-board
    table says so and names the Nano ESP32 for M4. The cyanoacrylate glue line stays.
    - ring-test.md: "Buy separately" drops the plastic bearing and names the Nano ESP32; M3, M4, the
    accepta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
2026-10-12 test(hardware): skip the perch moved-part check cleanly without pcbnew
    The test imported pcbnew before load_board, so the CI style job (no KiCad)
    raised ModuleNotFoundError instead of skipping. load_board now runs first.
2026-10-12 fix(enclosure): open the owl's bottom wall to the USB-C plug overmold
    J201's mouth sat 1.5 mm behind the wall's outer face and the 9.6 x 3.6 mm
    slot only passed the plug shell, so an overmold stopped on the wall about
    1 mm short of full mating. The wall is now cut through to 13.0 x 7.0 mm on
    the plug axis (the perch's R48 clearance for the 12.35 x 6.5 mm Type-C
    overmold), and tests sweep that overmold to 0.3 mm from the mouth and check
    the full wall round the opening.
2026-10-12 fix(hardware): key the dock-pad board so it only fits with J2 towards J303
    The dock-pad board and its recess were symmetric, so the board could be glued
    in turned round, which puts the perch's 5 V on GPIO1 through the DET pad.
    The pad section now has a 3.0 mm round-ended notch in its DET end, and the
    back cover's recess a tongue that fills it up to the board's back face:
    turned or turned over, the board stands 1.6 mm proud and cannot be glued
    flat. The pad section also carries "J2 towards J303 >" on its silkscreen.
    assembly.md step 7 states the orientation and a meter check before the first
    dock (J303 pin 2 to the pad nearest J2, pin 3 to the farthest); step 8 says
    which side "right" means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
2026-10-12 docs(hardware): bring the charger note on the power sheet to ISET 3.3k
    The notes text box still described the 2.0k ISET and the 1000 mAh pack. It now
    gives 0.270 A (0.239 to 0.298 A), at most 0.43 C of the 700 mAh pack, and a
    27 mA precharge, as the symbol and rev-a.md do.
2026-10-12 docs(hardware): bring the rev A status up to date
    Placement, routing, the perch board and perch v1 are done and reviewed and the
    fabrication files are ready; the ring test runs after delivery.
2026-10-12 docs(hardware): note that the perch LED is the one pad-number exception
    The rotation method matches EasyEDA and KiCad pads by number. That carries
    KiCad's pin functions for every polarised part except the perch LED (C2286),
    whose EasyEDA pin 1 is the anode: its CPL (180, no offset) is right and must
    not get a 180 offset.
2026-10-12 docs(hardware): answer the perch board's edge rail question in ordering.md
    If JLC asks, the perch board gets the main board's answer: rails added by
    JLCPCB, tab routed, no tabs at J1 or in the dock-pad key notch, nubs filed
    flush.
2026-10-12 ci(hardware): give KiCad its default library tables before ERC and DRC
    The kicad/kicad image ships the symbol and footprint libraries but no
    library tables, so every part was reported as a library missing from the
    configuration (319 ERC and 100 DRC warnings on the main board). With the
    template tables in the config directory both counts are 0, as they are
    locally.
2026-10-13 feat(hardware): put the touch lines on a 1.8 V side through an LSF0204
    VIEWE (13 October 2026): the CST820's I2C may not be pulled up to 3.3 V.
    design.toml gains U306 (XC6206P182MR, DISP_1V8 from DISP_3V3), U305
    (LSF0204PWR, refB on DISP_3V3, refA and EN on DISP_1V8), C311, C312, the
    R310 bleeder, the 1.8 V pull-ups R311 to R314 and R315 (0R, not fitted,
    fallback to a 3.3 V touch bus). J301 pins 27 to 30 move to the TP_*_1V8
    nets; R301 to R303 stay on the ESP32-S3 side. J301 and touch comments
    now name the VG V1.1 spec, the FPC3-HD143Y002M adapter and the CST820.
    DISP_1V8 joins the Power net class (setup.toml, applied to the project
    file). The design tests pin the 1.8 V pull-ups and a new t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
2026-10-13 feat(hardware): draw the touch level shift on the periph sheet
    U305 (LSF0204PWR) and U306 (XC6206P182MR) with C311, C312, R310 and the
    1.8 V pull-ups R311 to R314 go below the J301 notes, as in design.toml.
    J301 pins 27 to 30 now carry TP_SCL_1V8, TP_SDA_1V8, TP_RST_1V8 and
    TP_INT_1V8; TP_* stay on U201, R301 to R303 and U305's B side. R315
    (0R, the fallback to a 3.3 V touch bus) is drawn across U306 and marked
    DNP, out of the BOM and the position files.
    The J301 table, the "Values and why" box and the GPIO table on mcu_usb
    now name the CST820 (0x15), the VIEWE V1.1 spec, the 40 MHz QSPI clock
    and the touch lines' path through U305 at 1.8 V.
2026-10-13 chore(hardware): date the main board's title blocks 13 October 2026
    hw_titleblock.py now holds a date per board, the day its design last
    changed: the main board moves to 2026-10-13 with the touch level shift,
    the perch board stays at 2026-10-11. The four main board schematics
    carry the new date; the PCB title block and the back silk date (hw_silk
    reads the same value) follow when the board is next synced and marked.
2026-10-13 feat(hardware): move J301 to where VIEWE's standard display adapter reaches
    VIEWE confirmed the panel's connector sits 13.04 mm left of and 4.22 mm above
    the display centre and that its standard adapter FPC is 24.148 mm long from the
    connector's front face. The contract now puts J301 at owl (-5.00, 4.22), rot 270
    on the front, entry facing 9 o clock: the adapter leaves the panel connector,
    makes one U-turn over the H2 lug and an S-bend down to J301 with 0.77 mm to
    spare, and J301 pin k still meets panel pin 32 - k.
    owl_params cites the VG V1.1 specification with the 48.16 mm glass and gains
    the adapter constants (PANEL_CONN_*, ADAPTER_*, J301_FPC_DEPTH). A new front
    keep-out, "display adapt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
2026-10-13 feat(firmware): move the rev A board header to the CST820 touch controller and a 40 MHz panel clock
2026-10-13 feat(hardware): place the touch level shift and the moved J301 on the main board
    hw_sync.py brings U305, U306, C311, C312 and R310 to R315 onto the
    board and moves J301 pins 27 to 30 to the TP_*_1V8 nets; R315 takes
    DNP, exclude from BOM and exclude from position files from its symbol.
    hw_contract.py apply moves and locks J301 at (-5.00, 4.22) rot 270 and
    draws the new "display adapter path" keep-out.
    hw_place.py: C301 and C302 at the section 2 points east of J301's
    DISP_3V3 pins. The section 2 points for the translator overlapped
    (U305's courtyard is 7.8 mm wide), so the block is laid out again
    outside the actuator strip x -3.7 to -2.4: U305 at (2.0, -1.6); the
    1.8 V pull-ups in a row belo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
2026-10-13 feat(hardware): hand-route J301's new position and the touch level shift
    Delete the copper the moved J301 and the new translator block sit on: every
    Freerouting track and via of TP_SDA, TP_SCL, TP_INT and TP_RST; the F.Cu
    segments of EXP_A, EXP_B, HALL_INT, I2C_SDA, IMU_INT1 and BTN_BEAK that touch
    x -9 to 9, y -9 to 11, with the vias I2C_SDA (5.13, -3.72) and (-7.44, -1.43)
    and HALL_INT (-6.93, -0.40); CHG_SUSPEND's copper in that window (it ran under
    J301's new position); the GND links to the old qspi and j301_fanout vias; and
    the stubs this leaves dangling (KiCad's own dangling test).
    hw_route.py: j301_comb() for J301 at rotation 270 (rows along y), new qspi,
    j301_fanout and disp_3v3 gro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
2026-10-13 feat(hardware): route the nets the moved J301 displaced
    Freerouting 2.4.1 (only these nets connectable in the DSN, every other track
    and via fixed, In1 and In2 as power layers without planes) routed HALL_INT,
    CHG_SUSPEND, BTN_BEAK and the I2C_SDA link from U303 to the U301 side; the
    session's wires for those nets were added to the board, nothing else. It left
    EXP_A, EXP_B, IMU_INT1 and the I2C_SDA link from U304 unrouted after two runs:
    EXP_A and EXP_B (3 vias each, round the west edge to J202) and the U304 link
    (east of TPS_PG to U102's run) come from a grid router with the same class
    clearances, kept off the antenna end, the crystal, U302 and L101.
    hw_route.py: late_links gains IMU_INT1 (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
2026-10-13 feat(hardware): refill the outer pours and find the pour vias again
    The moved J301 and the touch level shift change which regions of the F.Cu
    and B.Cu GND pours the tracks enclose. pour_vias now holds 15 vias (9 on
    F.Cu regions, 6 on B.Cu), each at the deepest spot of its region outside the
    courtyards (the module's excepted, as before) and clear of other copper on
    both outer layers; one of them joins C301 and C302's GND pads, which the
    touch lanes fence off north of U305. The old pour via that R310's pad sat
    over is gone, so R310 pad 1 has no hole clearance error.
    A DRU rule keeps the pours off C312's GND pad, which reaches GND through its
    own track to the via beside it (the pad has no room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
2026-10-13 feat(hardware): add a GND return via by the QSPI clock vias and keep the D101 pour via
    A GND via between the LCD_CLK and LCD_D0 vias gives their return current a
    path between In2 (under the B.Cu run from the module) and In1 (under the F.Cu
    run into J301); the pour via north-west of them does the same for LCD_D2.
    The B.Cu region beside D101 keeps the pour via the earlier search found
    there; the new search left it out only because its disk touches D101's
    courtyard by 0.05 mm.
2026-10-13 fix(hardware): widen IMU_INT1's lane and put back TE's GND return via
    IMU_INT1's B.Cu lane at x 5.3 is now 0.15 mm, the Default class width, and
    rev A's GND via beside LCD_TE's via at owl (-11.0, 24.18) is back in the qspi
    group. The qspi comment says the west row lanes return through J301's GND
    vias, and hw_place.py says why R310 and R311 keep their earlier positions.
    Zones refilled; no existing via changed net. DRC 0 / 0 / 0.
2026-10-13 test(hardware): check that each U305 A pin carries its B pin's signal
    The LSF0204 passes An to Bn, so pins 2 to 5 must carry the 1.8 V copies of
    the nets on pins 13 to 10 (B net plus "_1V8"). A design.toml with two B nets
    swapped passed the old touch-side test and fails this one.
2026-10-13 docs(hardware): refresh the main board's order counts and review evidence
    ordering.md takes the BOM and CPL counts hw_fab.py now reports (47 rows,
    45 LCSC numbers, 96 designators; 96 parts, 18 top and 78 bottom).
    rev-a-review.md reruns its checks on the VIEWE VG board: the hw_fab,
    Gerber, analyzer, SPICE and stock rows, J301's contact 1 and 31 with their
    silk marks, the findings whose counts or nets changed, the nets crossing the
    In2 +3V3 boundary and the hidden reference count. U305 and U306 get rows in
    the datasheet table and a line in the rotation comparison.
2026-10-13 docs(hardware): give the adapter fit check its 1:1 print command
    The adapter fit check in rev-a.md now names the kicad-cli command that
    writes the board front at 1:1 to one A4 page, with a drawing sheet
    (j301-fit-check.kicad_wks) that carries two 10 mm bars and says how to
    check the print scale. It replaces a path that never existed. The display
    adapter route table marks the row inside the panel connector as not
    counted and says how the sum takes the two straight runs.
2026-10-13 docs(hardware): check the panel supply for a short before DISP_EN goes high
    Bring-up step 6 now starts with the DISP_3V3 to GND resistance check, panel
    plugged in and board unpowered, instead of ending with it. Step 1 is
    rewrapped to 100 columns.
2026-10-13 docs(hardware): say what is still asked of VIEWE about J301's VBAT pin
    The J301 comment in design.toml cited a question number from a private
    email; it now says that the VBAT pin level (3.3 V or 3.7 to 4.5 V) is still
    being asked of VIEWE.
2026-10-13 docs(hardware): bring ordering, review and bring-up notes in line with the VG board
    Fix the order-day placement counts and add the adapter fit check decision,
    rewrite the FPC accepted risk for the computed route, list the cheap touch
    checks before R315, copy the firmware power-up sequence, correct the QSPI
    clock, the connector sign comment and the fit-check scale wording.
2026-10-13 docs(hardware): rewrap the power-up rule and the main board verdict
2026-10-14 feat(enclosure): export the assembled owl and perch as meshes for product renders
    render_export.py writes each visible part in owl coordinates, the perch body and the owl's docked
    placement to build/render/, so renders show the parts exactly as built.
2026-10-14 feat(tools): product renders in Blender from the enclosure and board files
    tools/render.sh exports the enclosure meshes and KiCad's GLB of the main board, then renders four
    scenes with Cycles: a launch shot, the owl docked on a desk, the owl in a jeans pocket and an
    exploded view. The screen shows the simulator's golden frame.
2026-10-14 docs: lead the README with product renders and a shorter pitch
    The README opens with the launch render, the desk and pocket shots and an exploded view, then a
    spec table, the controls and the simulator screens; the build commands move into a collapsed
    section. The renders come from tools/render.sh.
2026-10-14 feat(web): a product landing page with a volume ring you can turn
    The site's front page now shows the owl: the renders, a ring that turns with a pointer, the mouse
    wheel or the arrow keys (24 clicks per turn, 2 percent each, as on the device), the controls, the
    round screens, an exploded view with the specifications and the Car Thing comparison. Inter is
    self-hosted under its licence so the page keeps the strict content security policy.
2026-10-14 chore(tools): render at the size and sample count the committed images use
2026-10-16 feat(hardware): wire the touch lines straight to J301 at 3.3 V
    VIEWE's reply of 16 October 2026 corrects their earlier answers: the
    panel's TP_SDA, TP_SCL, TP_INT and TP_RST are 3.3 V logic, the module has
    no pull-ups of its own, and the host wants 4.7k to 3.3 V on SDA and SCL
    and a pull-up on INT. That is rev A's touch circuit, and a 1.8 V high is
    below the CST820's VIH (0.7 x 3.3 V), so the level shift comes out.
    design.toml drops U305 (LSF0204PWR), U306 (XC6206P182MR), C311, C312 and
    R310 to R315. J301 pins 27 to 30 carry TP_SCL, TP_SDA, TP_RST and TP_INT
    again; R301 and R302 (4.7k) and R303 (10k) to DISP_3V3 stay, and TP_RST
    stays push-pull from GPIO40. The J301 comment now records VBAT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
2026-10-16 feat(hardware): take the touch level shift off the periph sheet
    U305, U306, C311, C312, R310 to R315 and their labels, wires and power
    symbols go, with the "Touch level shift" heading and the LSF0204PWR and
    XC6206 library symbols. J301 pins 27 to 30 carry TP_SCL, TP_SDA, TP_RST
    and TP_INT again, in the labels and the J301 table.
    The "Values and why" box gives the touch bus as 3.3 V logic with no
    pull-ups in the panel and VBAT as 3.3 to 5.5 V (VIEWE's reply of 16
    October 2026), and drops the level shift and R315 notes. The GPIO table
    on mcu_usb no longer routes INT, RST and I2C1 through U305.
    The main board's date moves to 2026-10-16, the day its design changed;
    the schematics carry it, the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
2026-10-16 chore(hardware): drop the LSF0204PWR symbol nothing uses
    The touch level shift is gone from the main board, so the symbol, its
    PARTS and DATASHEET entries and its row in hardware/lib/README.md come
    out. The rebuilt owltunes.kicad_sym equals the committed one.
2026-10-16 feat(hardware): route J301's touch pins straight to the 3.3 V touch lines
    hw_sync.py takes U305, U306, C311, C312 and R310 to R315 off the board
    and puts J301 pins 27 to 30 on TP_SCL, TP_SDA, TP_RST and TP_INT.
    hw_place.py and its reference spots drop them.
    hw_route.py's touch_shift group becomes "touch": the A side runs from
    J301 keep their paths (TP_SDA and TP_INT from the east row, TP_SCL
    through its two vias under J301, TP_RST round J301's south end) and go
    on east on F.Cu at y -0.3, -0.95, -1.6 and -2.25, where U305 sat, to
    R301 to R303 and the B side vias; the runs from there to the module are
    unchanged. The DISP_3V3 feed to R301 to R303 now ends at R303, and the
    DISP_1V8 runs, U305's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
2026-10-16 docs(firmware): describe the touch bus as wired straight to the panel
    board_owltunes_reva.h no longer routes I2C1 and TP_RST through U305: the
    CST820 sits on the 3.3 V touch lines with 4.7k to DISP_3V3, and TP_RST
    is push-pull. Pins, the 0x15 address and the 100 ms reset wait stay.
2026-10-16 docs(hardware): take the touch level shift out of the rev A docs
    VIEWE's reply of 16 October 2026 puts the touch lines at 3.3 V, so:
    - rev-a.md: the block diagram, the power budget, the I2C and touch level
    decisions (with the VIEWE answer and the CST820 VIH reason) and the
    bring-up items lose U305, U306, DISP_1V8 and the R315 fallback. The
    touch-level and VBAT questions to VIEWE are answered (VBAT 3.3 to
    5.5 V) and leave the open items.
    - bringup.md: no U305 or U306 to inspect, no DISP_1V8 or R315 steps; the
    touch bus swings 0 to 3.3 V at J301. The DISP_3V3 short check before
    DISP_EN stays.
    - pinmap.md: TP_INT, TP_RST, TP_SDA and TP_SCL without U305 and the
    DISP_1V8 pull-ups;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
2026-10-16 docs(hardware): cite VIEWE's 14 October reply for VBAT
    VIEWE answered the VBAT question (3.3 to 5.5 V, so DISP_3V3 is fine) in
    their reply of 14 October 2026, not in the touch reply of 16 October.
    The J301 comment in design.toml, the "Values and why" box on the periph
    sheet and the panel supplies row in rev-a.md now say so.
2026-10-16 docs(hardware): close the VIEWE questions the 14 October reply answered
    rev-a.md lists only the connector front face and the CO5300 init code as open, notes the +-0.5 mm
    adapter tolerance and makes the fit check come before the board order. ordering.md orders the
    standard 52.6 mm glass panel and 4 adapters. Smaller wording fixes in pinmap.md, the periph sheet
    and hw_place.py.
2026-10-17 fix(enclosure): take the panel connector face from VIEWE's STEP model
    VIEWE's connector model (reply of 17 October 2026) puts the panel connector's
    front face 1.60 mm from its centre, not the assumed 1.92. The adapter test's
    tolerance corner becomes face +0.15, adapter -0.5 (VIEWE's +-0.5 mm) and
    panel-side depth 2.6, which leaves 0.27 mm of slack (1.09 nominal), and the
    U-turn apex is checked at every tolerance corner (22.11 mm at most).
    rev-a.md takes the new route numbers, and the adapter fit check becomes a
    confirmation at assembly instead of a step before the board order.
2026-10-17 feat(enclosure): seat the 52.6 mm cover glass in front of the bearing
    VIEWE's reply of 14 October 2026: the 48.16 mm glass is discontinued, and the
    52.6 mm glass is wider than the 6710 bearing's bore. The glass now rests on
    0.2 mm tape on the bezel's front face, flush with the bearing's front face
    1.3 mm behind the glass front; the bezel loses its lip and glass pocket, and
    the bearing is set flush on a flat plate and held by epoxy on its seat. The
    ring lip opens to 53.6 mm and still stands 1.3 mm in front of the glass.
    To keep the owl 23.5 mm deep and the board where it is, the magnets become
    D3 x 1 mm N52 and the carrier's flange moves beside the pockets (carrier 7.5
    to 9.5, ring body to 8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
2026-10-17 docs(hardware): describe the face for the 52.6 mm glass
    The 52.6 mm glass rests on 0.2 mm tape in front of the bearing and nothing
    else holds it (VIEWE's reply of 14 October 2026: the 48.16 mm glass is
    discontinued). rev-a.md takes the new mechanical stack, the 2.7 mm Hall gap,
    the tape-only retention and the bearing set on a flat plate with epoxy.
    ring-test.md and ordering.md buy D3 x 1 mm magnets and epoxy, ring-test.md and
    assembly.md set the bearing flush on a flat plate and tape the glass, and
    ordering.md and the enclosure README drop the glass retainer.
2026-10-17 fix(enclosure): keep a 1.0 mm wall between the jig's centre hole and pocket
    The sensor jig's centre hole left 0.92 mm to the SparkFun board pocket at
    9 o'clock, under the structural wall the jig's pocket walls need. The wall
    probes never looked at 180 degrees, where the pocket sits; they do now, and
    the hole is 27.8 mm, which leaves 1.02 mm.
2026-10-17 docs(hardware): take the adapter fit check out of the main board verdict
    The review still gated the order on the fit check and quoted the old route.
    The accepted-risk row now gives the connector face from VIEWE's STEP model
    (17 October 2026), the adapter's +-0.5 mm (reply of 14 October 2026), 1.09 mm
    of slack nominal and 0.27 mm at the worst corner, the 22.11 mm apex, and the
    fit check as a confirmation at assembly. J301's comment in pcb_contract.py
    takes the 1.09 mm too.
2026-10-17 docs(hardware): guard the glass ledge when epoxying the bearing
    The flat plate gets release film, and the bezel's and inner race's front faces
    are wiped clean before the epoxy sets, since they carry the glass tape.
    ring-test.md M5 measures the 6710ZZ in hand (inner race land against the
    52.75 mm glass edge, shields not proud of the race face, thicker tape if they
    are), and assembly step 9 points to it. The enclosure README adds the glass's
    printed border and the 1.0 mm slot at the side openings as owner review
    points. The assembly tools paragraph is rewrapped.
2026-10-18 feat(firmware): a shared CO5300 panel and touch component for the AMOLED boards
    owl_amoled drives the round CO5300 AMOLED over QSPI through esp_lcd's SPI
    panel IO and gives LVGL a display and a pointer for its touch controller.
    The command framing follows Espressif's esp_lcd_co5300. Pixels go out high
    byte first from two 20-line DMA buffers in internal RAM, the next block
    renders while the last is on the bus, every window adds the panel's column
    offset, and an invalidate-area handler aligns redrawn areas to 2 pixels.
    Touch is read after an INT edge or while a finger is down, for the CST816S
    family (rev A's CST820) and the CST9217 (the Waveshare kit).
    The pure parts build for the host: the c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
2026-10-18 feat(firmware): rev A and Waveshare AMOLED 1.75 board support
    Two new boards behind OWL_BOARD, both on the shared owl_amoled component:
    - owltunes_reva: the VIEWE panel with VIEWE's init table and 6-column
    offset at 40 MHz, the CST820 at 0x15 on I2C1 at 400 kHz, and the panel
    power order from the board header (DISP_EN high with both resets low,
    10 ms, release, first command 10 ms later, first touch read 100 ms after
    TP_RST). 16 MB QIO flash, 8 MB octal PSRAM and the USB-Serial/JTAG
    console as on the Nano. No status LED.
    - waveshare_amoled_175: pins, init table, 6-column gap, reset timings and
    the CST9217 at 0x5A from Waveshare's repository and ESP-IDF BSP (cited in
    the source)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
2026-10-18 docs(hardware): first-light checks for the AMOLED display and touch
    bringup.md gets a section for the first boot of rev A or the Waveshare kit:
    the log line to expect, how a wrong column offset, colour order or byte
    order looks, the 2-pixel alignment, and which touch switch to flip for a
    mirrored or swapped axis. README and CONTRIBUTING list the two new board
    builds, and the design document uses the BSP's real name.
2026-10-18 fix(firmware): read the CST9217 only after its INT edge
    A CST9217 frame read between reports has no 0xAB marker or a status other
    than 6 and decodes as finger up, so polling it while a finger was down could
    break a drag or a long press into clicks. It is now read only after an INT
    edge, as Waveshare's LVGL adapter does; the CST816 family keeps the reads
    while a finger is down, so a missed edge on its lift report cannot leave the
    pointer pressed.
    Also from review:
    - The flush wait is bounded at 100 ms, logs an error and marks the flush
    ready, so a stuck transfer cannot freeze the UI loop.
    - Raw touch coordinates and their mapping are logged at debug level.
    - The VIEWE table comment says th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
2026-10-18 docs: render the owl with the 52.6 mm glass face
    The four product renders (launch, desk, pocket, exploded) are redone from the enclosure after the
    52.6 mm glass face and the board after the touch level shift came off. Same scenes and settings
    (tools/render.sh, 1920 x 1080, 256 samples).
2026-10-20 feat(enclosure): owl v0 round the Waveshare AMOLED kit
    The low-cost owl: six MJF prints (body, ring, bezel, hub, back cover,
    beak key) round the Waveshare ESP32-S3-Touch-AMOLED-1.75 kit, 66 x 84 x
    19.7 mm. The hub is the chassis: the ring turns on its tube between the
    glued bezel and its front face, the kit hangs from its arms by its three
    M2 standoffs, and a TMAG5273 module behind it reads the ring's 24
    magnets at a 2.65 mm gap. The ear tufts are flexures in the head's top
    wall over 3 x 6 mm switches. Every fastener is an M2 x 4 machine screw.
    The tests check every bought part's envelope for clearance (kit, USB-C
    plug, header wiring, battery and its plug, module, switches, magnets),
    the ri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
2026-10-20 feat(firmware): set the Waveshare kit's charge current to 200 mA
    The AXP2101's charge current comes from a factory efuse that Waveshare
    does not document. Owl v0 runs the kit on a 400 mAh cell, so the board
    support writes REG 62H on the touch controller's I2C bus at start-up:
    200 mA, 0.5 C. A failed write is logged and the display carries on.
2026-10-20 docs: owl v0 build guide and status
    docs/hardware/kit-owl.md lists the parts, the wiring by the kit's header
    labels, the assembly order and the checks on arrival. The README and the
    site now put owl v0 first and rev A after it.
2026-10-20 feat(render): owl v0 scenes from the kit enclosure
    render_export.py also writes owl v0 to build/render/kit/: the six prints from owl_kit, and the
    kit, module, switches, magnets and battery from the envelopes the clearance tests use, split by
    material (glass, panel, board, USB-C, header, standoffs, sockets). owl_render.py gains two scenes:
    kit, owl v0 standing on the desk set, and kit-exploded, its stack exploded like the v1 view. The
    desk set and the exploded studio are shared with the v1 scenes, which render as before.
2026-10-20 docs: show owl v0 in the README, the site and its build guide
    Two renders of owl v0 from the kit enclosure (tools/render.sh kit kit-exploded, 1920 x 1080,
    256 samples, like the v1 set): standing on the desk, and exploded from the kit to the back cover.
    The README gains an "Owl v0" section with both, the site an "Owl v0 comes first" photo section
    above the status, and kit-owl.md shows them above the section figure.
2026-10-21 chore(deps): bump certifi from 2026.7.22 to 2026.10.19 in /enclosure (#12)
    Bumps [certifi](https://github.com/certifi/python-certifi) from 2026.7.22 to 2026.10.19.
    - [Commits](https://github.com/certifi/python-certifi/compare/2026.07.22...2026.10.19)
    ---
    updated-dependencies:
    - dependency-name: certifi
    dependency-version: 2026.10.19
    dependency-type: indirect
    ...
2026-11-03 chore(deps): bump certifi to 2026.10.23 in /enclosure (#14)
    GitHub's dependency graph still listed certifi 2026.7.22 after #12, so a
    new advisory (fixed in 2026.10.18) opened an alert against it. Locking
    the current release also makes it read the lockfile again.
